bjnhur/WIZpm/01.Serial_to_ethernet_module/03.WIZ750SR-100/05.ETC/WIZ750SR-100_image/WIZ750SR-100_module_picture.png

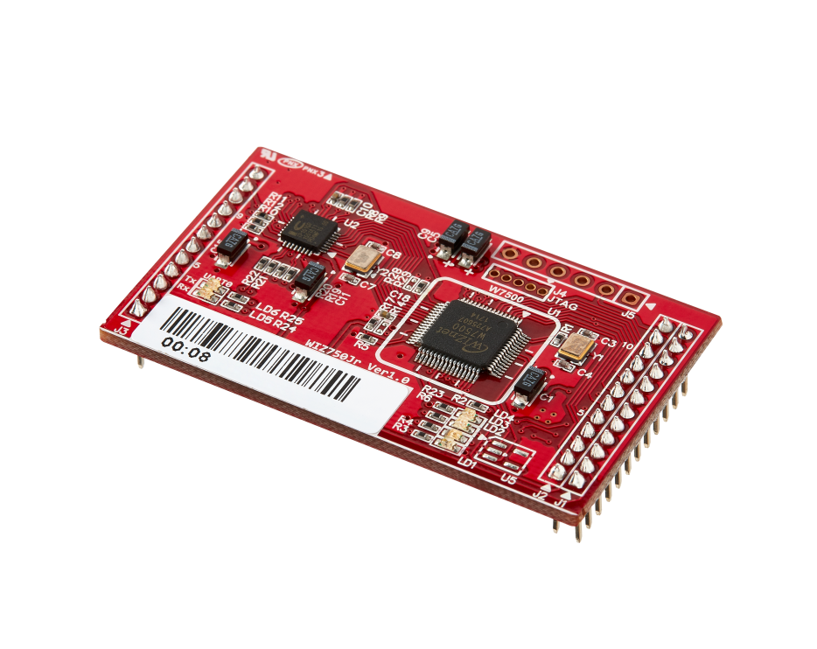
01.Serial_to_ethernet_module/03.WIZ750SR-100/05.ETC/WIZ750SR-100_image/WIZ750SR-100_module_picture.png
