bjnhur/WIZpm/README.md

# WIZpm
WIZnet product Management

File server와 WIZPM에서 설계 자료 수집 및 제품 버전업 히스토리 파악
원본 파일과 PDF 파일 공유
Github wiki 작성
파일명 통일 - 제품명_파일종류_버전.xxx
- 파일종류
- 회로도 - SCH
- 거버파일 - GB
- 파트리스트 - PL
- 데이터시트 - DS
- 유저가이드 - UG
- 생산가이드 - PG 

버전 관리

V1.00 ⇒ V100, V2.01 ⇒ V201
ex) WIZwiki-W7500_SCH_V100
