bjnhur/WIZpm/01.Serial_to_ethernet_module/03.WIZ750SR-100/05.ETC/WIZ750SR-100_Pinout.pptx

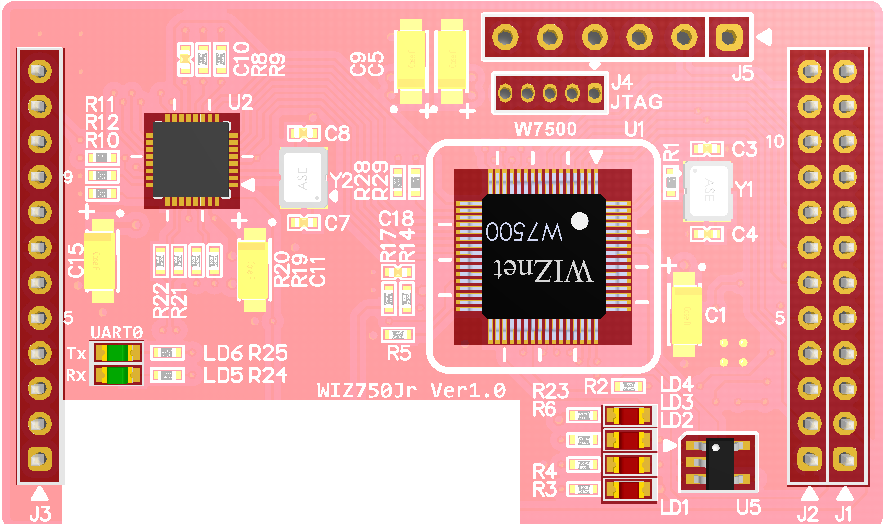
[picture p2: figure]

Expansion ISP port

JTAG

PHY

2

1x12
Network Trans Line

1x12
Data Trans Line

Main MCU
W7500

1

EEPROM

3

4

Indicate LED

Power LED

5

1x12
Expansion GPIO / App Boot / ISP Port

## Slide 2

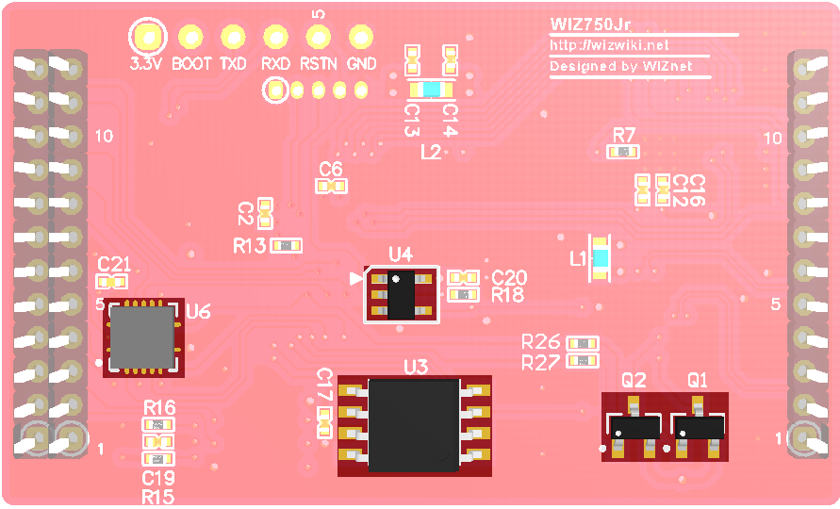
[picture p3: figure]

Qurdruple
3-state Buffer

6

7

Not Gate

PNP Transistor

9

Data Flash

8

## Slide 3

Expansion ISP port

JTAG

PHY

1x12
Network Trans Line

1x12
Data Trans Line

Main MCU
W7500

EEPROM

UART TX/RX LED

Indicate LED

Power LED

1x12
Expansion GPIO / App Boot / ISP Port

## Slide 4

Qurdruple
3-state Buffer

Not Gate

PNP Transistor

Data Flash

## Slide 5

JTAG

Network
Line
(10/100M) Ethernet

PA_04

VCC_3.3V

SWDIO

GND

/RESET

U_RXD2

PC_11

ISP

Data
Line

PA_03

SWCLK

/RESET

U_TXD2

BOOT

PC_10

GND

VCC_3.3V

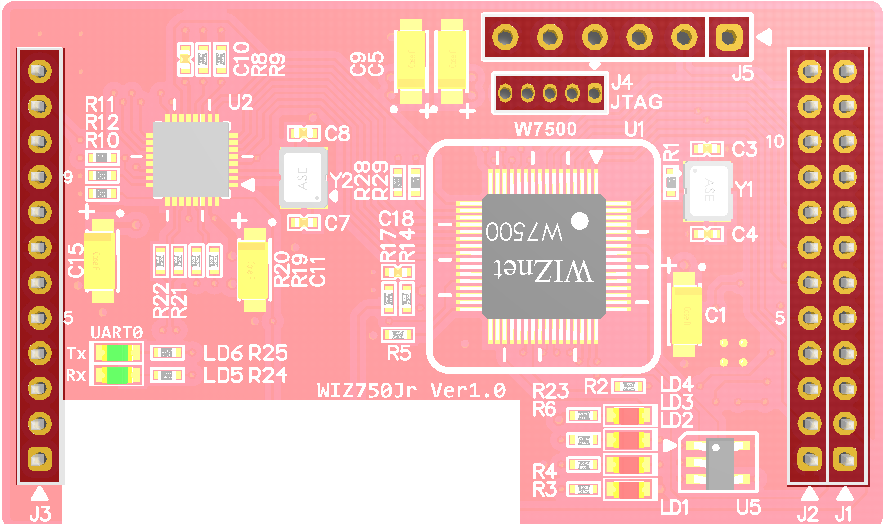
[picture p4: figure]

VCC_3.3V

STATUS

PA_07

PB_05

COL

PHY_AD3

GND

U_DSR

PA_09

NC

PHY_AD0

U_CTS

U_RXD

PA_11

PA_14

GND

MDI_TP

MDI_TN

GND

U_DTR

U_RTS

PA_10

PA_12

GND

MDI_RP

U_TXD

GND

PA_13

MDI_RN

NC

/RESET

VCC_3.3V

GND

APP_BOOT

EX_GPIOA

EX_GPIOB

EX_GPIOC

EX_GPIOD

U_RXD2

U_TXD2

BOOT

STAT_LED1

STAT_LED0

GND

PA_08

PC_15

PC_14

PC_13

PC_12

PC_11

PC_10

PC_09

PC_08

Optional Line
(Debug, Expansion GPIO, Status LED)

## Slide 6

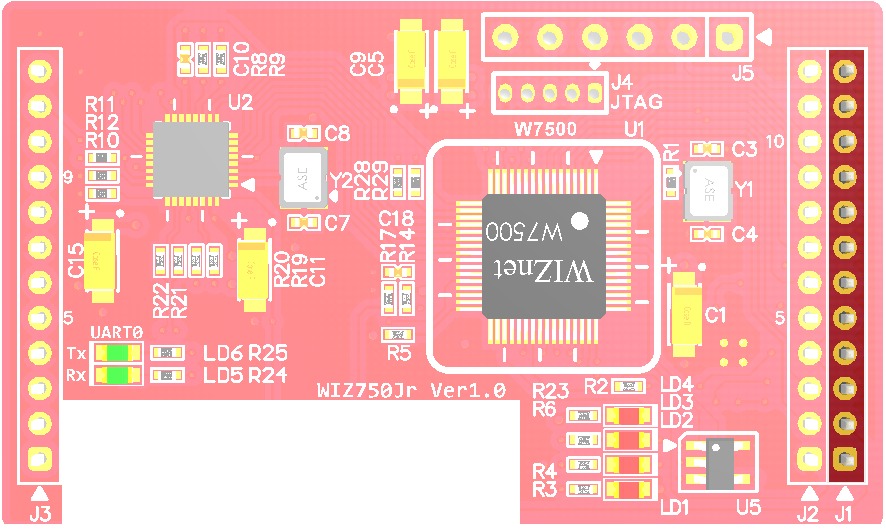
[picture p5: figure]

STATUS

GND

U_DSR

U_CTS

U_RXD

GND

U_DTR

U_RTS

U_TXD

GND

/RESET

VCC_3.3V

## Slide 7

VCC_3.3V

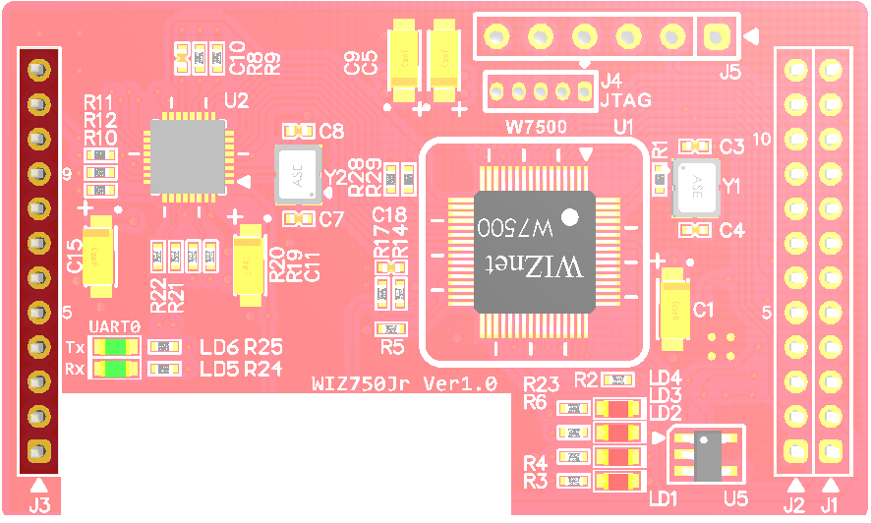
[picture p6: figure]

COL

PHY_AD3

NC

PHY_AD0

GND

MDI_TP

MDI_TN

GND

MDI_RP

MDI_RN

NC

## Slide 8

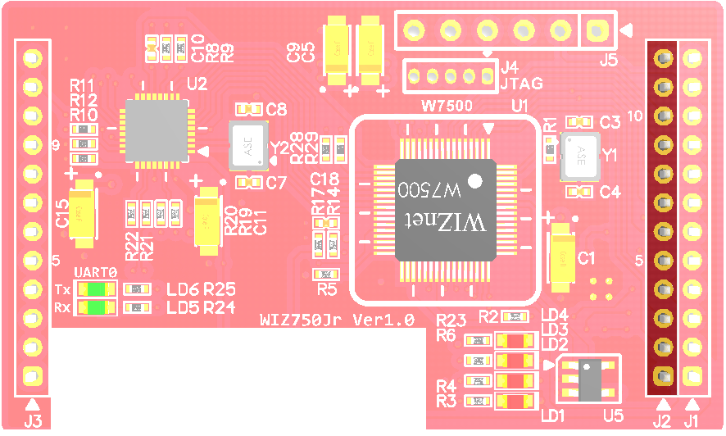
[picture p7: figure]

GND

APP_BOOT

EX_GPIOA

EX_GPIOB

EX_GPIOC

EX_GPIOD

U_RXD2

U_TXD2

BOOT

STAT_LED1

STAT_LED0

GND

## Slide 9

JTAG

GND

PA_03

/RESET

SWCLK

PA_04

SWDIO

VCC_3.3V

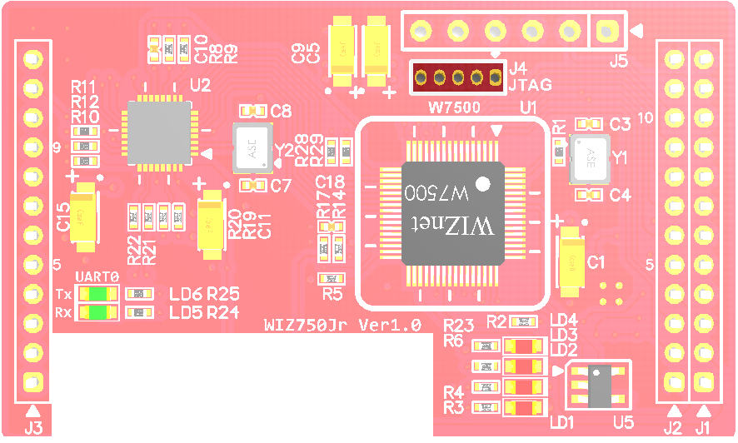
[picture p8: figure]

## Slide 10

GND

/RESET

U_RXD2

PC_11

ISP

U_TXD2

BOOT

PC_10

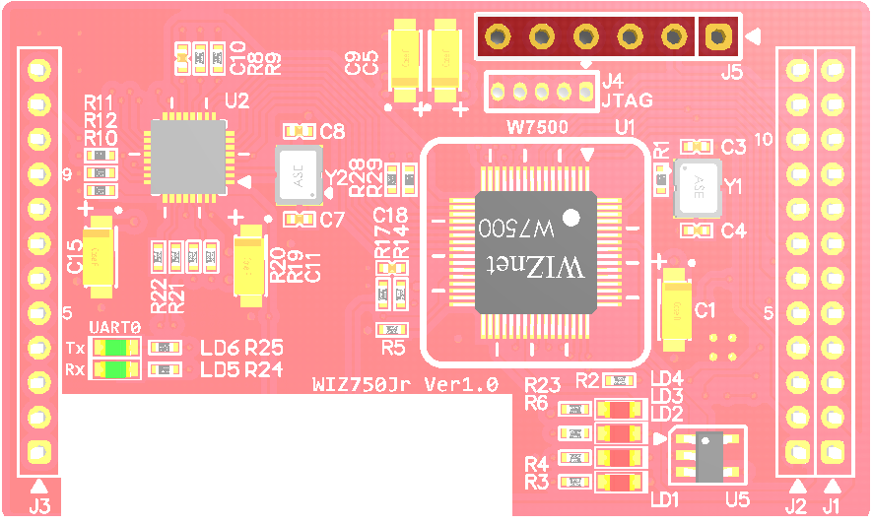
[picture p9: figure]

VCC_3.3V

## Slide 11

Indicate LED
(10/100_LED(ACT/LINK))
(COL LED) etc

Expansion GPIO

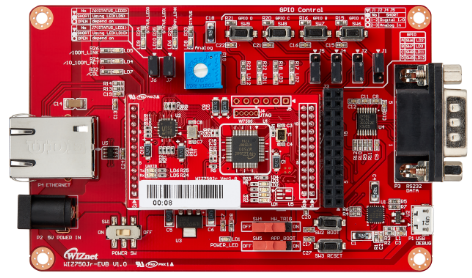
[picture p10: figure]

RS-232
Connector
(D-SUB9)

RJ-45
Connector

Power
Adapter

Micro USB B type
Debug/ISP Port

Boot Switch

Reset Switch

Power Switch

Mode Switch
Normal/Config

App Boot
Switch
