bjnhur/WIZpm/01.Serial_to_ethernet_module/06.WIZ750SR-110/05.ETC/WIZ750SR_110_Pinout.pptx

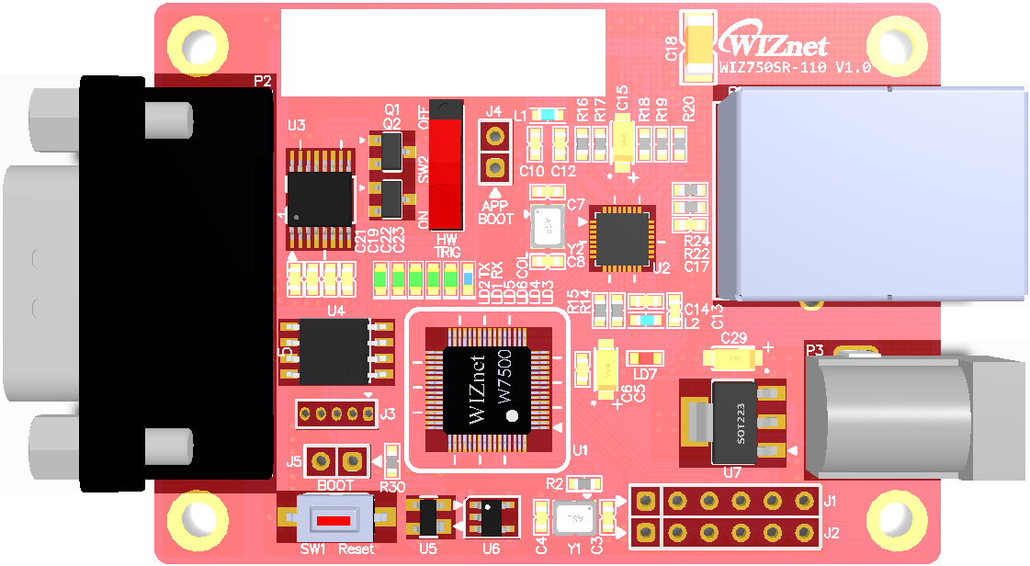
[picture p11: figure]

D-SUB9 Connector

8

RS-232C Transceiver

7

PNP Transistor

4

RJ-45
Ethernet Connector

3

App Boot

HW_TRIG
Slide SW

Main MCU
W7500

5

6

17

Data Flash

9

1

PHY

2

5v to 3.3v LDO

18

5V DC-JACK

10

11

16

JTAG

Boot

EEPROM

14

Expansion GPIO port

Expansion ISP port

15

Reset
Push SW

12

Reset IC

13

## Slide 2

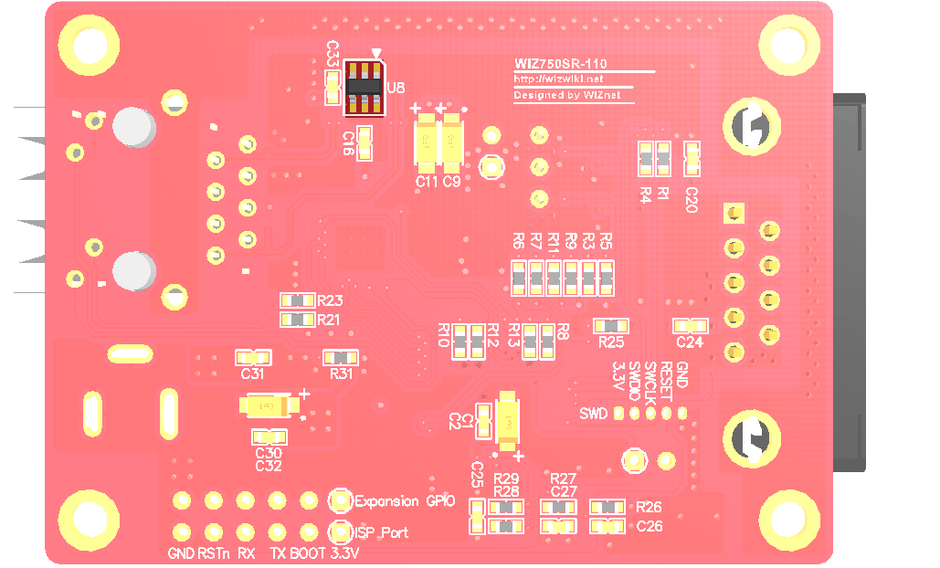
[picture p12: figure]

Ethernet line
ESD Protect

19

## Slide 3

D-SUB9 Connector

RS-232C Transceiver

PNP Transistor

RJ-45
Ethernet Connector

App Boot

HW_TRIG
Slide SW

Main MCU
W7500

Data Flash

PHY

5v to 3.3v LDO

5V DC-JACK

JTAG

Boot

EEPROM

Expansion GPIO port

Expansion ISP port

Reset
Push SW

Reset IC

## Slide 4

Ethernet line
ESD Protect

## Slide 5

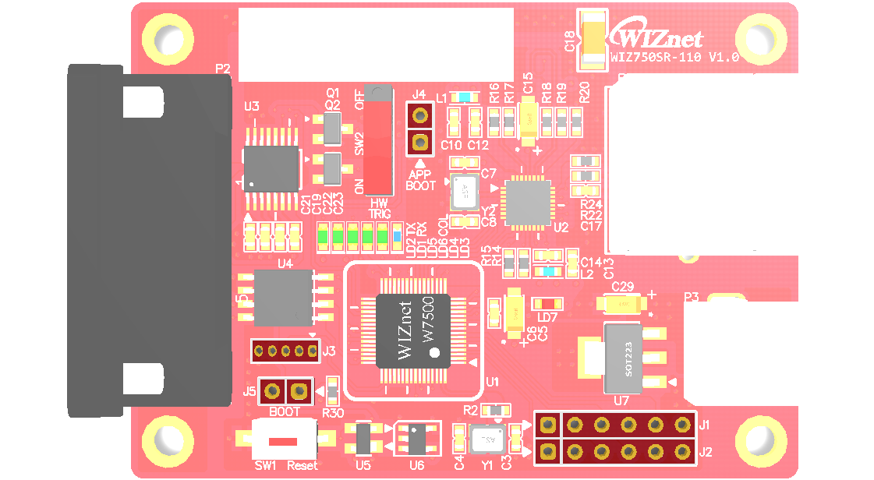
[picture p13: figure]

GND

APP BOOT

Boot

JTAG

PA_04

VCC_3.3V

SWDIO

PA_03

SWCLK

/RESET

VCC_3.3V

Expansion
GPIO

GND

GPIO_D

GPIO_C

GPIO_B

PC_12

PC_13

PC_14

GPIO_A

GND

PC_15

VCC_3.3V

BOOT

Boot

GND

ISP

/RESET

U_RXD2

PC_11

U_TXD2

BOOT

PC_10

VCC_3.3V

## Slide 6

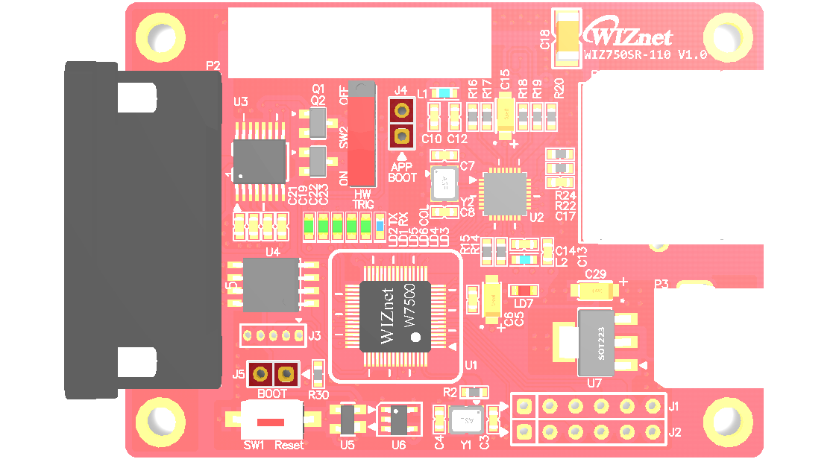
[picture p14: figure]

GND

APP BOOT

Boot

VCC_3.3V

BOOT

Boot

## Slide 7

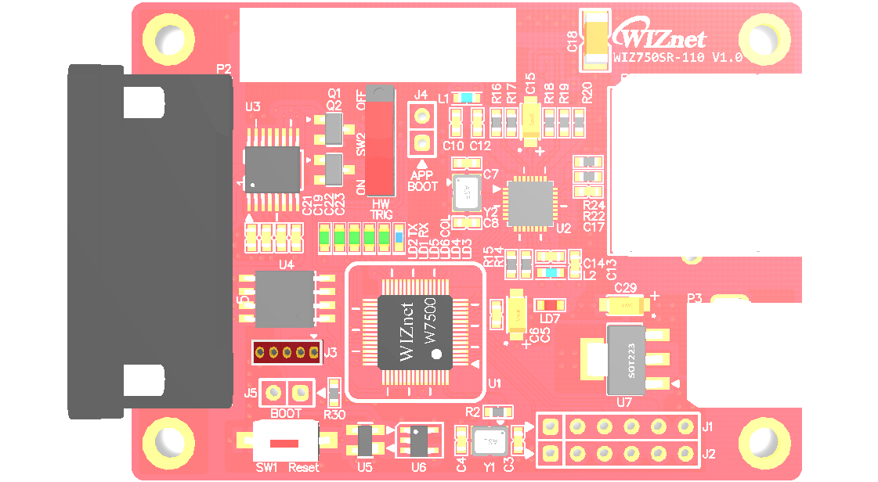
[picture p15: figure]

JTAG

PA_04

VCC_3.3V

SWDIO

PA_03

SWCLK

/RESET

GND

## Slide 8

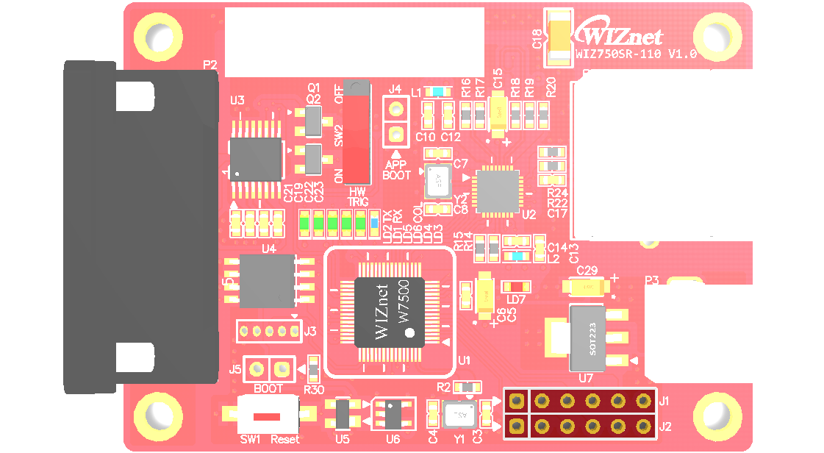
[picture p16: figure]

VCC_3.3V

Expansion
GPIO

ISP

GPIO_D

GPIO_C

GPIO_B

PC_12

PC_13

PC_14

GPIO_A

GND

PC_15

GND

/RESET

U_RXD2

PC_11

U_TXD2

BOOT

PC_10

VCC_3.3V

## Slide 9

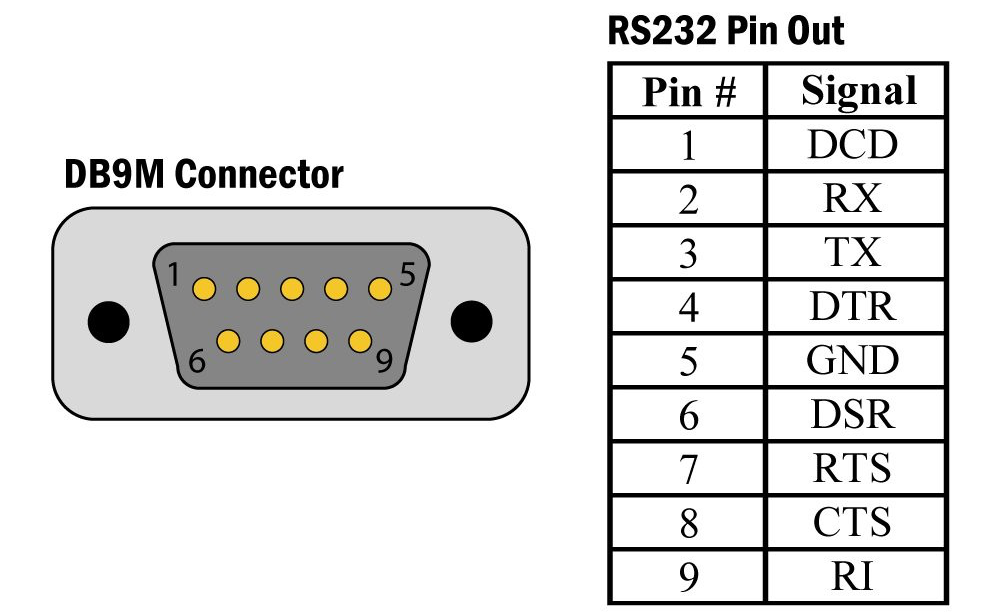
[picture p17: figure]
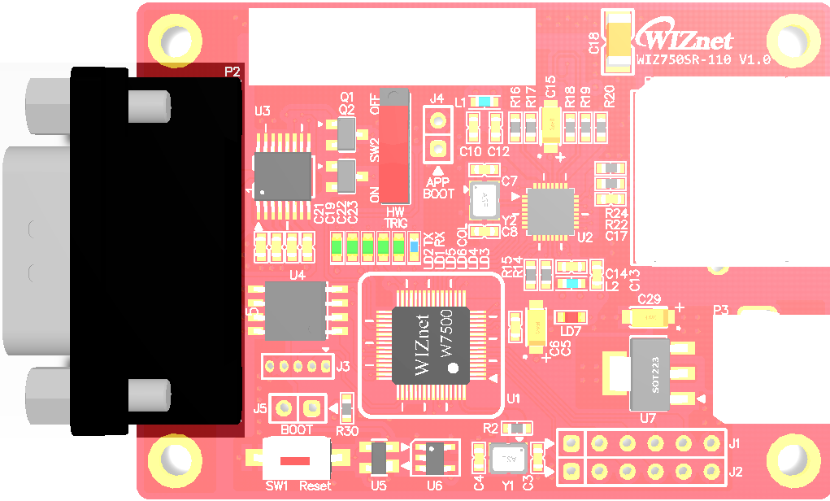
[picture p18: figure]

## Slide 10
