bjnhur/WIZpm/01.Serial_to_ethernet_module/02.WIZ750SR-EVB/05.ETC/WIZ750SR_EVB_BlockDiagram.pptx

<WIZ750SR-EVB (TTL/RS232)>

H/W Trig
Slide SW

BOOT
Slide SW

APP_BOOT
Slide SW

Reset SW
Tact SW

TVS Diode
SP0503BAHTG

Micro USB
Connector

ISP/Debug

DC JACK

Diode
BAT60A

USB to UART Bridge
CP2104

Debug UART

WIZ750SR

Digital In/out

Expansion GPIO Test

Diode
BAT60A

Power SW

3.3V LDO

Power LED

5V

RS232C
Serial Port
D-SUB9-MALE

DATA line

RS-232C
Transceiver

TTL / RS232 Operation
Jumper Select

Analog In

Potentialmeter

LED

LED

LED

LED

Tact SW

Tact SW

Tact SW

Tact SW

## Slide 2

<WIZ750SR-EVB (RS422/485)>

H/W Trig
Slide SW

BOOT
Slide SW

APP_BOOT
Slide SW

Reset SW
Tact SW

TVS Diode
SP0503BAHTG

Micro USB
Connector

ISP/Debug

DC JACK

Diode
BAT60A

USB to UART Bridge
CP2104

Debug UART

WIZ750SR

Digital In/out

Expansion GPIO Test

Diode
BAT60A

Power SW

3.3V LDO

Power LED

5V

RS422/485
Serial Port
ECH381R 6P

DATA line

Analog In

Potentialmeter

LED

LED

LED

LED

Tact SW

Tact SW

Tact SW

Tact SW
