bjnhur/WIZpm/01.Serial_to_ethernet_module/05.WIZ750SR-105/04.Documents/WIZ750SR-105_PG_V100.pdf

# WIZ750SR-105 Production Guide

## (Version 1.0)

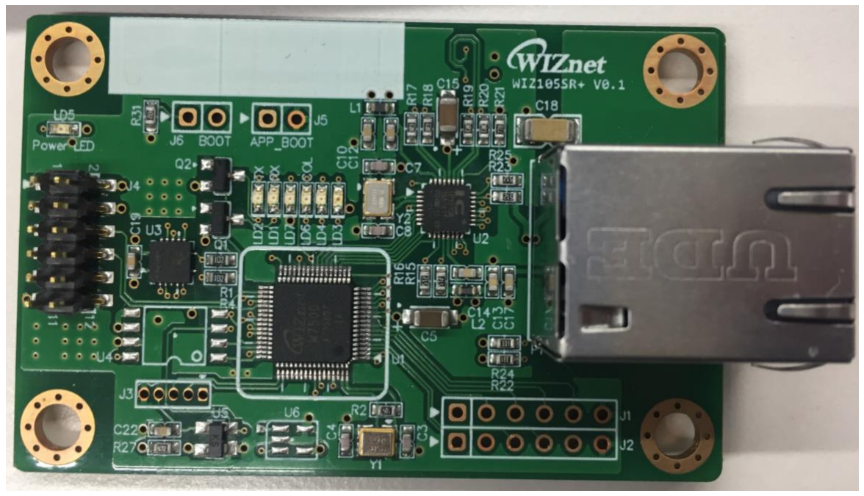
[picture p41: figure]

2018-01-15

ⓒ2016 WIZnet Co., Inc. All Rights Reserved.

☞For more information, visit our website at http://www.wiznet.io

WIZ750SR Production Guide (Version1.0) | 2

목차

## 1. 작업 환경 구성

### 1. 소프트웨어 환경

1. PC (Window 7 이상)
2. Python 2.7.13 program (파일로 제공)

파일이 없을 시 아래 설명 확인.

i. (https://www.python.org/downloads/release/python-2713/) 링크로 접속, Python

2.7.13 Windows x86-64 MSI installer 다운로드 (PC가 64bit일 경우)

ii. (32bit PC라면 Windows x86 MSI installer를 다운로드)

3. Mbed Serial Driver (파일로 제공)
| 파일이 없을 시 아래 설명 확인.
i. (https://os.mbed.com/handbook/Windows-serial-configuration) 링크로 접속.
| Download the mbed Windows serial port driver의 “Download latest driver” 클릭하 여 다운로드

### 2. WIZwiki 보드 mbed COM port 확인

1. WIZwiki-W7500P에 USB 케이블을 연결한 뒤, PC의 장치관리자에 들어가서 “mbed
| Serial Port”가 나오는지 확인한다.”


### 3. 프로그램 설치

1. Python 2.7.13 프로그램 설치

설치파일 실행 후 전부 “Next” 누르고 설치.

2. 환경변수 추가하기.

아래 사진과 같이 제어판 -> 시스템 -> 고급 시스템 설정 -> 환경변수로 접속한다.

그리고 시스템 변수의 Path에 C:\Python27;C:\Python27\Scripts 을 기입한 뒤 확인

을 누르고 나온다.


3. PyOCD 설치하기
i. 아래 사진과 같이 시작메뉴의 찾기 메뉴에서 명령 프롬프트(cmd)를 실행한다.

(주의: 반드시 인터넷이 연결되어 있어야 함.)

ii. | cmd환경에서 pip install --pre -U pyocd 명령어를 입력한 뒤 enter를 누른다.
| 그러면 아래 사진 처럼 pyOCD가 설치 된다.


iii. | 그리고 제공해 준 파일을 아래 사진과 같이 아래의 경로에 각각 복사한다.
| C\Python27\Lib\site-packages\pyOCD
| Flash_w7500.py >> Flash 폴더
| Mbed_board.py >> board 폴더
| Target_w7500.py >> target 폴더


## 2. 하드웨어 연결

### 1. 테스트 환경 준비 및 하드웨어 연결

- 테스트 환경
1. WIZwiki-W7500P & WIZwiki-W7500 board (둘 중에 하나 사용)
2. WIZ750SR-105
3. WIZ105SR-EVB Board

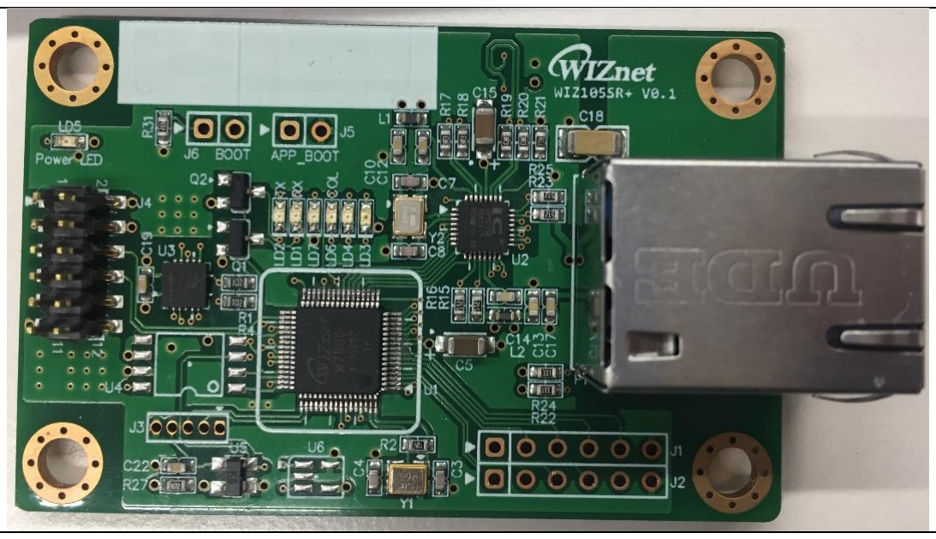
[picture p42: figure]

WIZ750SR-100 보드

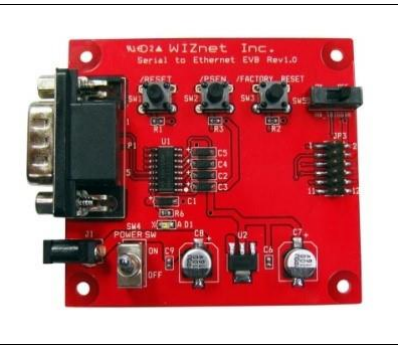
[picture p43: figure]

WIZ105SR-EVB

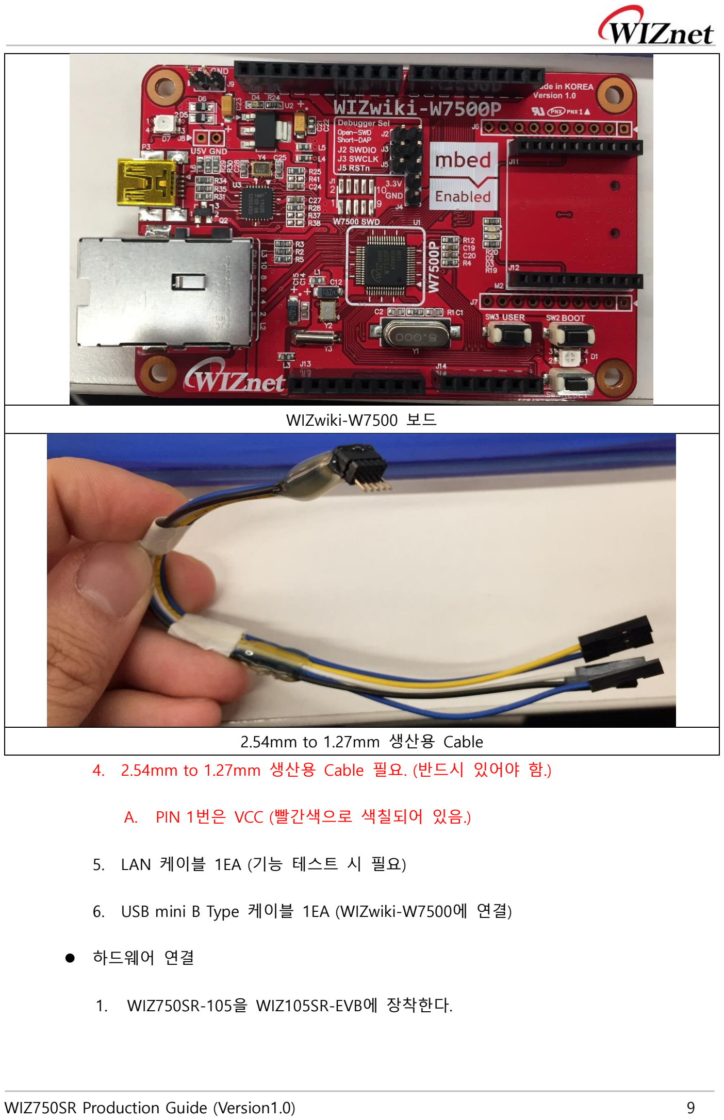
[picture p44: page 9]

WIZwiki-W7500 보드

2.54mm to 1.27mm 생산용 Cable

4. 2.54mm to 1.27mm 생산용 Cable 필요. (반드시 있어야 함.)
A. PIN 1번은 VCC (빨간색으로 색칠되어 있음.)
5. LAN 케이블 1EA (기능 테스트 시 필요)
6. USB mini B Type 케이블 1EA (WIZwiki-W7500에 연결)
- 하드웨어 연결
1. WIZ750SR-105을 WIZ105SR-EVB에 장착한다.

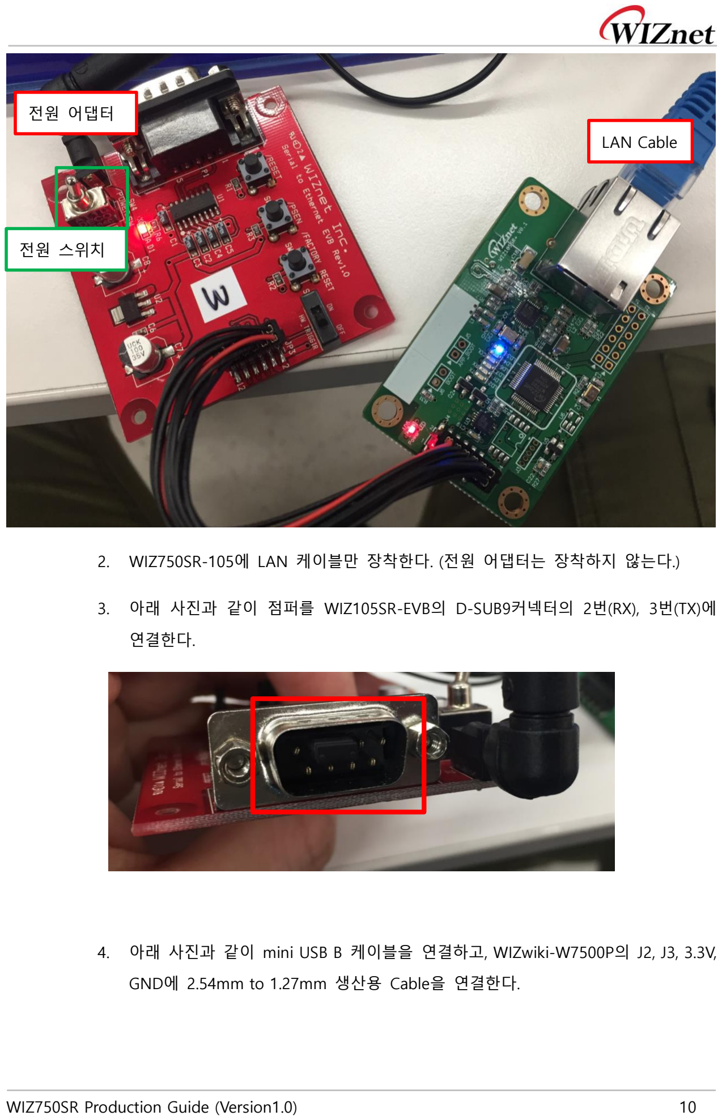
[picture p45: page 10]

2. WIZ750SR-105에 LAN 케이블만 장착한다. (전원 어댑터는 장착하지 않는다.)
3. 아래 사진과 같이 점퍼를 WIZ105SR-EVB의 D-SUB9커넥터의 2번(RX), 3번(TX)에

연결한다.

4. 아래 사진과 같이 mini USB B 케이블을 연결하고, WIZwiki-W7500P의 J2, J3, 3.3V,

GND에 2.54mm to 1.27mm 생산용 Cable을 연결한다.

LAN Cable

전원 어댑터

전원 스위치

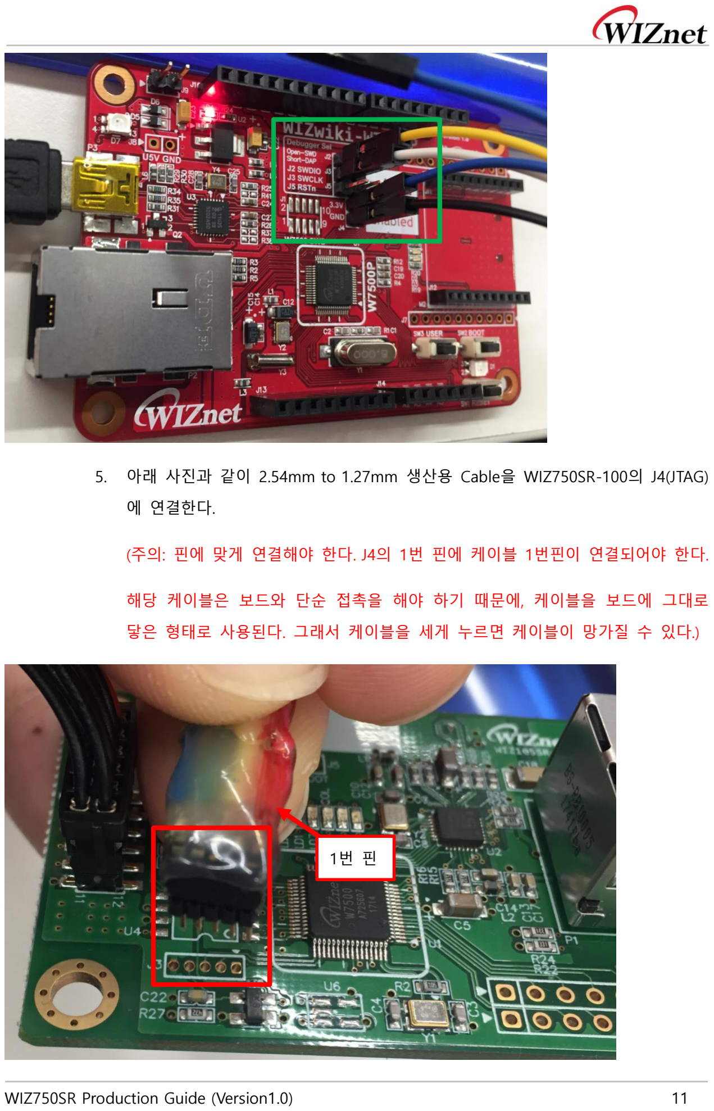
[picture p46: page 11]

5. 아래 사진과 같이 2.54mm to 1.27mm 생산용 Cable을 WIZ750SR-100의 J4(JTAG)

에 연결한다.

(주의: 핀에 맞게 연결해야 한다. J4의 1번 핀에 케이블 1번핀이 연결되어야 한다.

해당 케이블은 보드와 단순 접촉을 해야 하기 때문에, 케이블을 보드에 그대로

닿은 형태로 사용된다. 그래서 케이블을 세게 누르면 케이블이 망가질 수 있다.)

1번 핀

6. 정상적으로 연결 되었다면, 아래 사진과 같이 LD1 LED에 빨간 불이 점등된다.
7. 이 상태에서 펌웨어, 맥 어드레스 라이팅, 기능테스트를 진행한다.

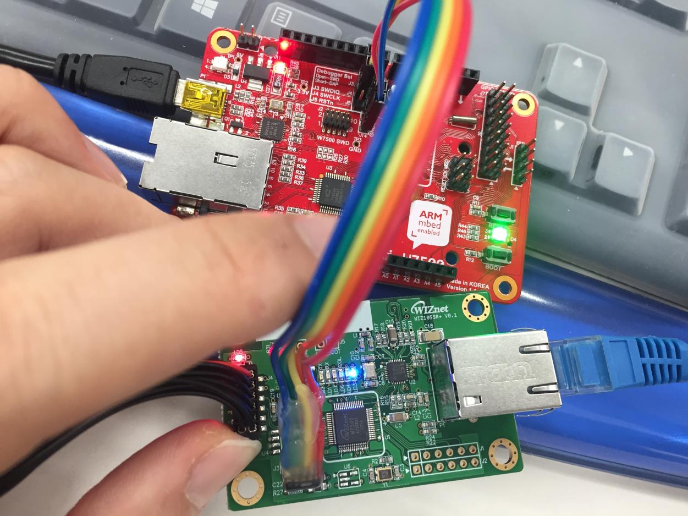
[picture p47: figure]

## 3. 펌웨어, 맥 어드레스 라이팅 및 기능 테스트

### 1. 펌웨어 라이팅

1. 펌웨어 다운로드 폴더로 접속한다. (제공한 파일 중 펌웨어 파일)

Ex) D:\Wiznet\WIZnet_product\_python_w7500_product\test_src_v2\test_src

2. 아래 사진과 같이 주소 표시줄에 cmd를 입력 후 Enter를 한다.


3. 그럼 아래 사진과 같이 cmd화면이 실행된다.
4. python w7500flashing.py -f W7500.bin 명령어를 입력하면 펌웨어 다운로드 시작한다.

해당 명령어가 나오면 펌웨어 다운로드

완료


### 2. 맥 어드레스 라이팅

1. 맥 어드레스 입력은 폴더의 macaddr.txt를 수정하여 MAC address를 수정할 수 있다.

아래 사진과 같이 맥 어드레스를 수정할 수 있다.

수정 후 저장한 뒤에 문서를 닫는다.

2. python w7500dataflashing.py 명령어를 입력하면 macaddr.txt에서 수정했던 맥 어드

레스가 라이팅 된다.

라이팅 된 후 자동 1씩 증가한다.

3. 여기까지 완료되었으면 라이팅 끝.

입력한 맥 어드레스

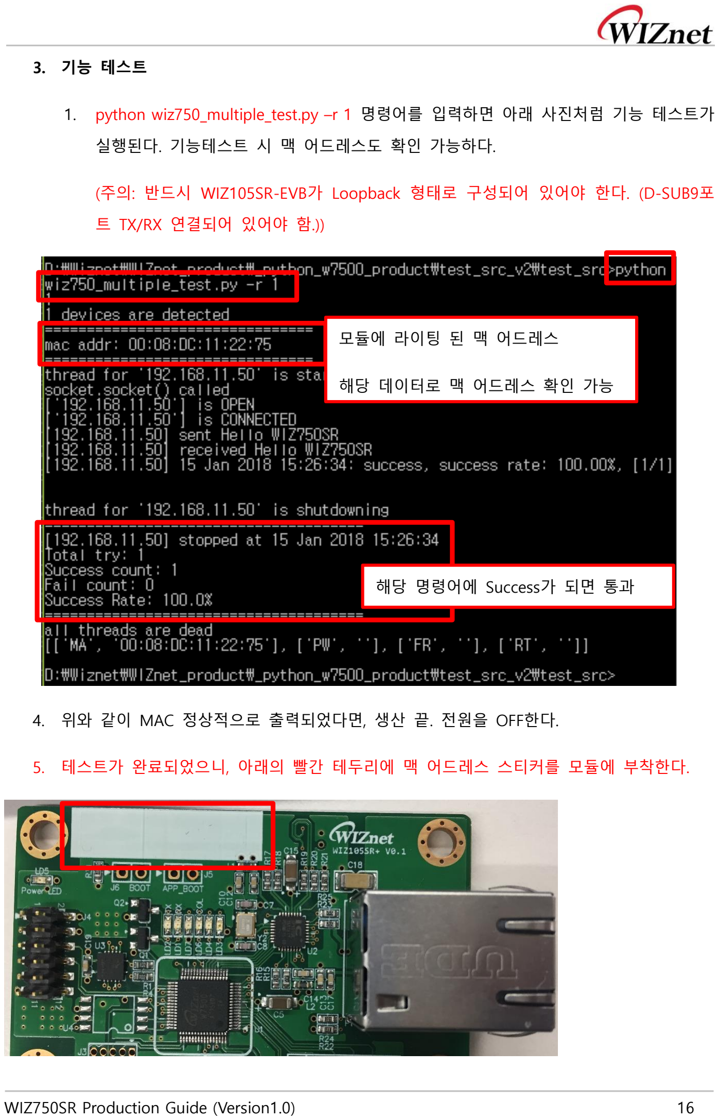
[picture p48: page 16]

### 3. 기능 테스트

1. python wiz750_multiple_test.py –r 1 명령어를 입력하면 아래 사진처럼 기능 테스트가

실행된다. 기능테스트 시 맥 어드레스도 확인 가능하다.

(주의: 반드시 WIZ105SR-EVB가 Loopback 형태로 구성되어 있어야 한다. (D-SUB9포

트 TX/RX 연결되어 있어야 함.))

4. 위와 같이 MAC 정상적으로 출력되었다면, 생산 끝. 전원을 OFF한다.
5. 테스트가 완료되었으니, 아래의 빨간 테두리에 맥 어드레스 스티커를 모듈에 부착한다.

해당 명령어에 Success가 되면 통과

모듈에 라이팅 된 맥 어드레스

해당 데이터로 맥 어드레스 확인 가능

## 4. 맥 어드레스 잘 못 입력했을 경우

1. 2. 하드웨어 연결에서 2. 2.54mm to 1.27mm 생산용 Cable을 WIZ750SR-105의 J4(JTAG)에

연결한다.

2. 펌웨어 다운로드 폴더로 접속한다. (제공한 파일 중 펌웨어 파일)

Ex) D:\Wiznet\WIZnet_product\_python_w7500_product\test_src_v2\test_src

3. 아래 사진과 같이 주소 표시줄에 cmd를 입력 후 Enter를 한다.


4. 그럼 아래 사진과 같이 cmd화면이 실행된다.
5. python w7500dataflashing.py -m 00:08:DC:xx:xx:xx 명령어를 입력하면 입력한 맥 어드레스

를 입력한다.

(주의: 해당 명령어는 macaddr.txt파일에 영향을 주지 않는다. 별도로 맥 어드레스를 입력

할 때 사용한다.)

별도로 입력된 맥 어드레스

## 5. 모듈에서 Error가 발생했을 때

1. 아래 사진과 같이 에러가 발생한다면, 다음과 같이 조치하면 된다.
A. Python W7500flashing.py(펌웨어 라이팅)할 때 발생하는 문제
i. 다시 한 번 라이팅 해본다.
ii. | 동일한 에러가 발생한다면, WIZwiki-W7500의 전원 OFF후 다시 ON한다.
iii. | 마찬가지로 W7500P-EVB보드도 전원 OFF후 다시 ON한다.


B. Python w7500dataflahing(맥 어드레스 라이팅)할 때 발생하는 문제.
i. WIZwiki-W7500의 전원 OFF후 다시 ON한다.

ii. 마찬가지로 W7500P-EVB보드도 전원 OFF후 다시 ON한다.

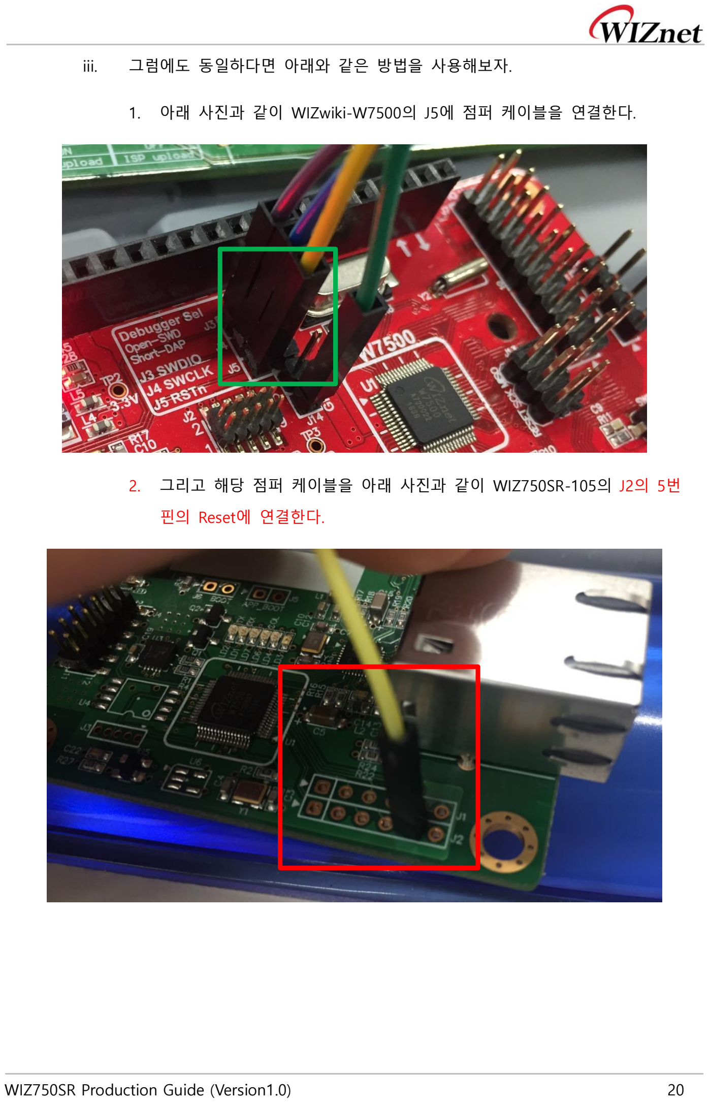
[picture p49: page 20]

iii. 그럼에도 동일하다면 아래와 같은 방법을 사용해보자.

1. 아래 사진과 같이 WIZwiki-W7500의 J5에 점퍼 케이블을 연결한다.
2. 그리고 해당 점퍼 케이블을 아래 사진과 같이 WIZ750SR-105의 J2의 5번

핀의 Reset에 연결한다.

3. 펌웨어 바이너리 파일을 WIZwiki-W7500의 이동식디스크에 드래그 앤 드랍

으로 복사한다.; 드래그 앤 드랍 복사

4. 그럼 아래 사진과 같이 다운로드가 시작된다.


5. 여기까지 완료되었다면, 다시 정상 동작한다.

## 6. WIZ750SR-105 생산 과정 요약

해당 생산 과정 요약본은 프로그램이 전부 설치되었다는 기준으로 설명한다.

1. WIZ750SR-105을 WIZ105SR-EVB에 장착한다.
2. WIZ105SR-EVB에 LAN 케이블만 장착한다. (전원 어댑터는 장착하지 않는다.)
3. 점퍼를 WIZ105SR-EVB의 D-SUB9커넥터의 2번(RX), 3번(TX)에 연결한다.
4. WIZwiki-W7500P보드에 mini USB B 케이블을 연결하고, J2, J3, 3.3V, GND에 2.54mm to

1.27mm 생산용 Cable을 연결한다.

5. 2.54mm to 1.27mm 생산용 Cable을 WIZ750SR-105의 J4(JTAG)에 연결한다.

(주의: 핀에 맞게 연결해야 한다. J4의 1번 핀에 케이블 1번핀이 연결되어야 한다.

해당 케이블은 보드와 단순 접촉을 해야 하기 때문에, 케이블을 보드에 그대로 닿은 형태

로 사용된다. 그래서 케이블을 세게 누르면 케이블이 망가질 수 있다.)

6. 펌웨어 다운로드 폴더로 접속한다. (제공한 파일 중 펌웨어 파일)
7. 아래 사진과 같이 주소 표시줄에 cmd를 입력 후 Enter를 한다.
8. python w7500flashing.py -f W7500.bin 명령어를 입력하면 펌웨어 다운로드 시작한다.
9. 맥 어드레스 입력은 폴더의 macaddr.txt를 수정하여 MAC address를 수정할 수 있다.
10. python w7500dataflashing.py 명령어를 입력하면 macaddr.txt에서 수정했던 맥 어드레스가

라이팅 된다.

11. python wiz750_multiple_test.py –r 1 명령어를 입력하면 기능 테스트가 실행된다. 기능테스

트 시 맥 어드레스도 확인가능하다.

(주의: 반드시 WIZ105SR-EVB가 Loopback 형태로 구성되어 있어야 한다. (D-SUB9포트

TX/RX 연결되어 있어야 함.))

12. 테스트가 완료되었으니, 맥 어드레스 스티커를 모듈에 부착한다.
