bjnhur/WIZpm/01.Serial_to_ethernet_module/02.WIZ750SR-EVB/01.Hardware/03.Partlist&BOM/01.WIZ750SR-EVB_TTL_PL/WIZ750SR-EVB_TTL_PL_V100.xls

WIZ750SR-EVB V1.0 TTL Version Partlist
Item | Q.ty | Reference | Part | Tech. Characteristics | Package
1 | 20 | C1,C2,C3,C4,C5,C6,C7,C8,C9,C10,C12,C14,C18,C19,C20,C21,C22,C23,C24,C25 | 0.1uF | 50V-5% Ceramic | CASE 0603
2 | 2 | C11,C15 | 4.7uF/16V | Tantal CAP, A Size, 4.7uF/16V, +/-20% | EIA/IECQ 3216
3 | 1 | C13 | 1uF | 50V-5% Ceramic | CASE 0603
4 | 2 | C16,C17 | 10uF/16V | Tantal CAP, A Size, 10uF/16V, +/-20% | EIA/IECQ 3216
5 | 2 | D1,D2 | BAT60A | Silicon Schottky Diode, 10V, 3A | SOD323
6 | 1 | D3 | Red LED | CHIP-LED, Red | CASE 0603
7 | 4 | D4,D5,D6,D7 | Green LED | CHIP-LED, Green | CASE 0603
8 | 4 | J1,J2,J3,J4 | 2.54mm 1x4 Pin haeder DIP | 2.54mm 1x4 Pin haeder DIP, Male | DIP
9 | 2 | J5,J6 | 2.54mm 1x2 Pin haeder DIP | 2.54mm 1x2 Pin haeder DIP, Male | DIP
10 | 4 | J8,J9,J10,J11 | 2.54mm 1x3 Pin haeder DIP | 2.54mm 1x3 Pin haeder DIP, Male | DIP
11 | 1 | J13 | 2.54mm 6x2 Pin Header Socket DIP | 2.54mm 6x2 Pin Header Socket DIP, Female | DIP
12 | 2 | J14,J15 | 2.54mm 1x6 Pin Header Socket DIP | 2.54mm 1x6 Pin Header Socket DIP, Female | DIP
13 | 1 | L1 | HH-1M1608-121JT | Bead for Power Line, 120[ohm] | CASE 0603
14 | 1 | P1 | D-SUB9-MALE | D-SUB 9PIN, Right-Angle, Male | R/A-Male
15 | 1 | P2 | 47346-0001 | Micro Mini B Type, SMD | SMD
16 | 1 | P3 | DC-JACK 2pi | DC Power Jack 2pi | DIP
17 | 5 | R1,R7,R8,R11,R12 | 4.7K | 1/10W-5% SMD | CASE 0603
18 | 2 | R2,R3 | 22R | 1/10W-5% SMD | CASE 0603
19 | 5 | R6,R9,R10,R13,R14 | 330R | 1/10W-5% SMD | CASE 0603
20 | 1 | R15 | WIW3386P / 10K | WIW3386P / 10K, Trimmer | DIP
21 | 1 | SW1 | SK-12D02 | 3 Port SW , SPDT ON-ON , 50V, 0.3A | DIP
22 | 5 | SW2,SW6,SW7,SW8,SW9 | IT-1101NHA-180G(SMD) | TACT Switch(SMD) | SMD
23 | 3 | SW3,SW4,SW5 | ITS-12H | Slide Switch(DIP) | DIP
24 | 2 | U1, U2 | SP3232EBEY | True +3.0V to +5.5V RS-232 Transceivers | TSSOP16
25 | 1 | U3 | CP2104-GM | SINGLE-CHIP USB-TO-UART BRIDGE, QFN-24 | QFN
26 | 1 | U4 | SP0503BAHTG | Little Fuse, Silicon Protection TVS Array Diode | SOT-143
27 | 1 | U5 | IL1117C-33ET | 3.3V 1A Low dropout Voltage Regulator | SOT-223
28 | 15 |  | 881545-1 | Jumper CAP | Item NO.8 &9 & 10에 장착 Item NO.8은 1-2 & 3-4 장착 Item NO.10중 J11은 2-3에 장착 나머지는 1-2번에 장착
29 | 1 | J7 | 2.54mm 1x2 Pin haeder DIP | Not Mount | DIP
30 | 1 | J12 | 2.54mm 1x6 Pin Header Socket DIP | Not Mount | DIP
31 | 1 | J16 | 2.54mm 1x2 Pin Header Socket DIP | Not Mount | DIP
32 | 1 |  | PCB | 2-Layer 83mm x 65mm
