bjnhur/WIZpm/01.Serial_to_ethernet_module/03.WIZ750SR-100/01.Hardware/01.Schematic/WIZ750SR-100_SCH_V100.pdf

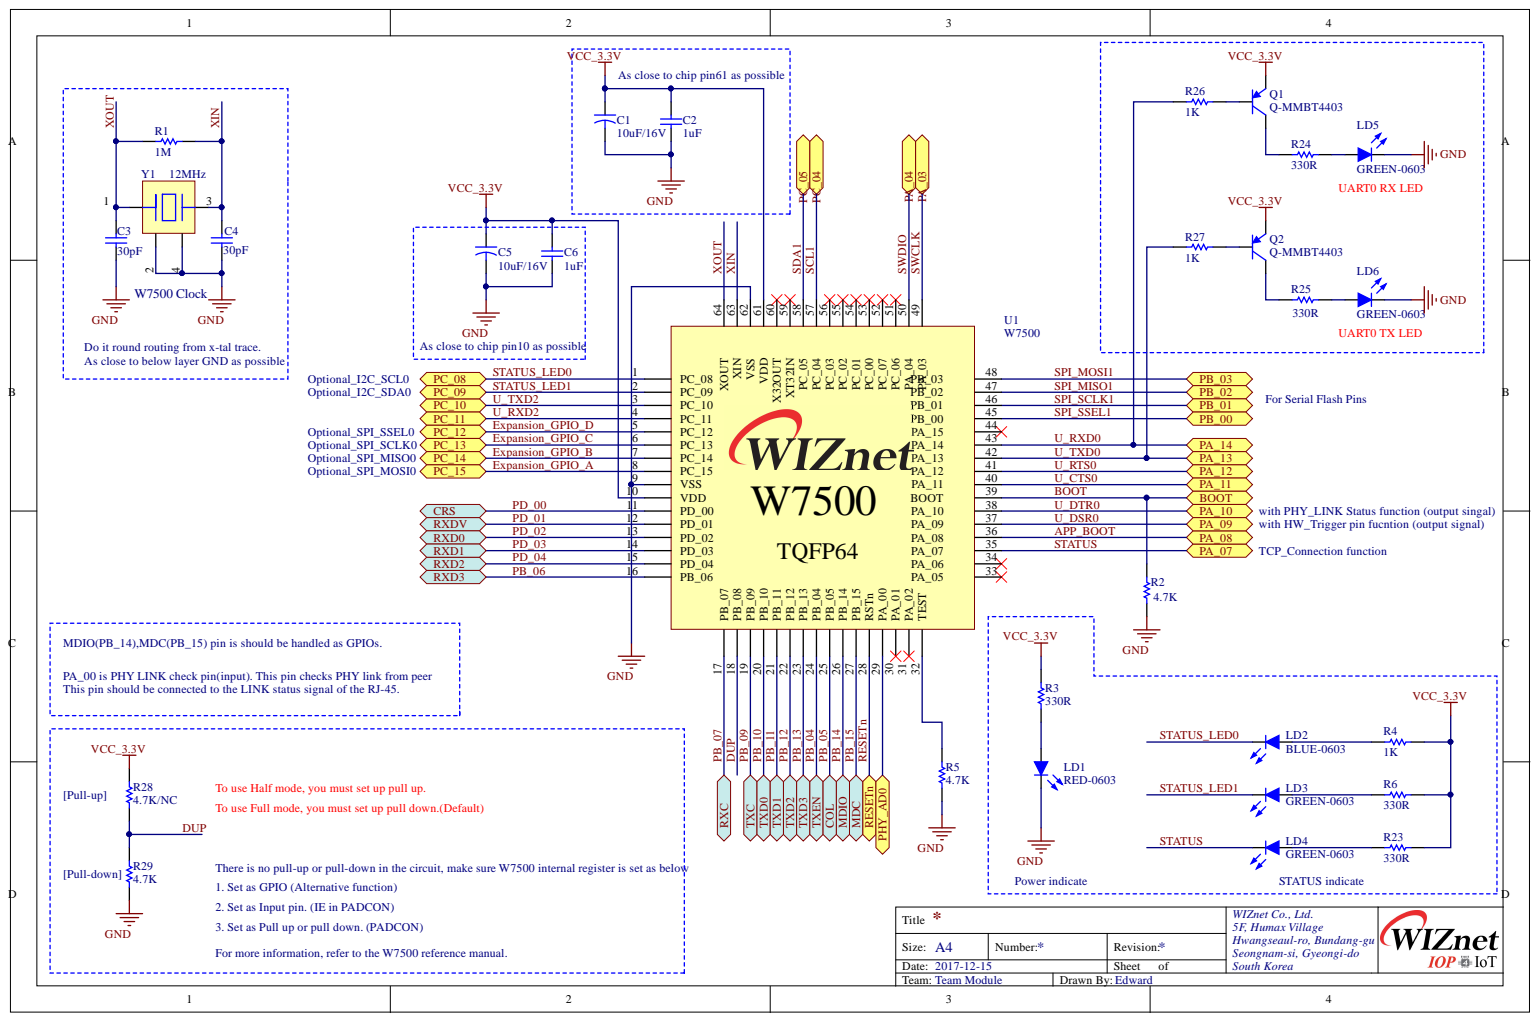
[picture p71: page 1]

VCC_ 3.3 | V

PC_ 0 8 PC_ 0 9 PC_ 1 0 PC_ 1 1 PC_ 1 2 PC_ 1 3 PC_ 1 4 PC_ 1 5 | W75 0 0 PA _ 1 0 PA _ 0 9 PA _ 0 8 TQFP64 PA _ 0 7 PA _ 0 6 0 5

GPIO _ D PC_12 | 5

GPIO _ C | 6
GPIO _ B | 7

A PC_14 GPIO _ | 8

0 | V D D PD _ 0 0 PD _ 0 1 PD _ 0 2 PD _ 0 3 PD _ 0 4 PB_ 0 6

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

A4 Team Mo Size: | * N umber: | * Rev i s i o n :

7-1 2-1 | | Sheet o f
d u l e | Draw n By : E d ward

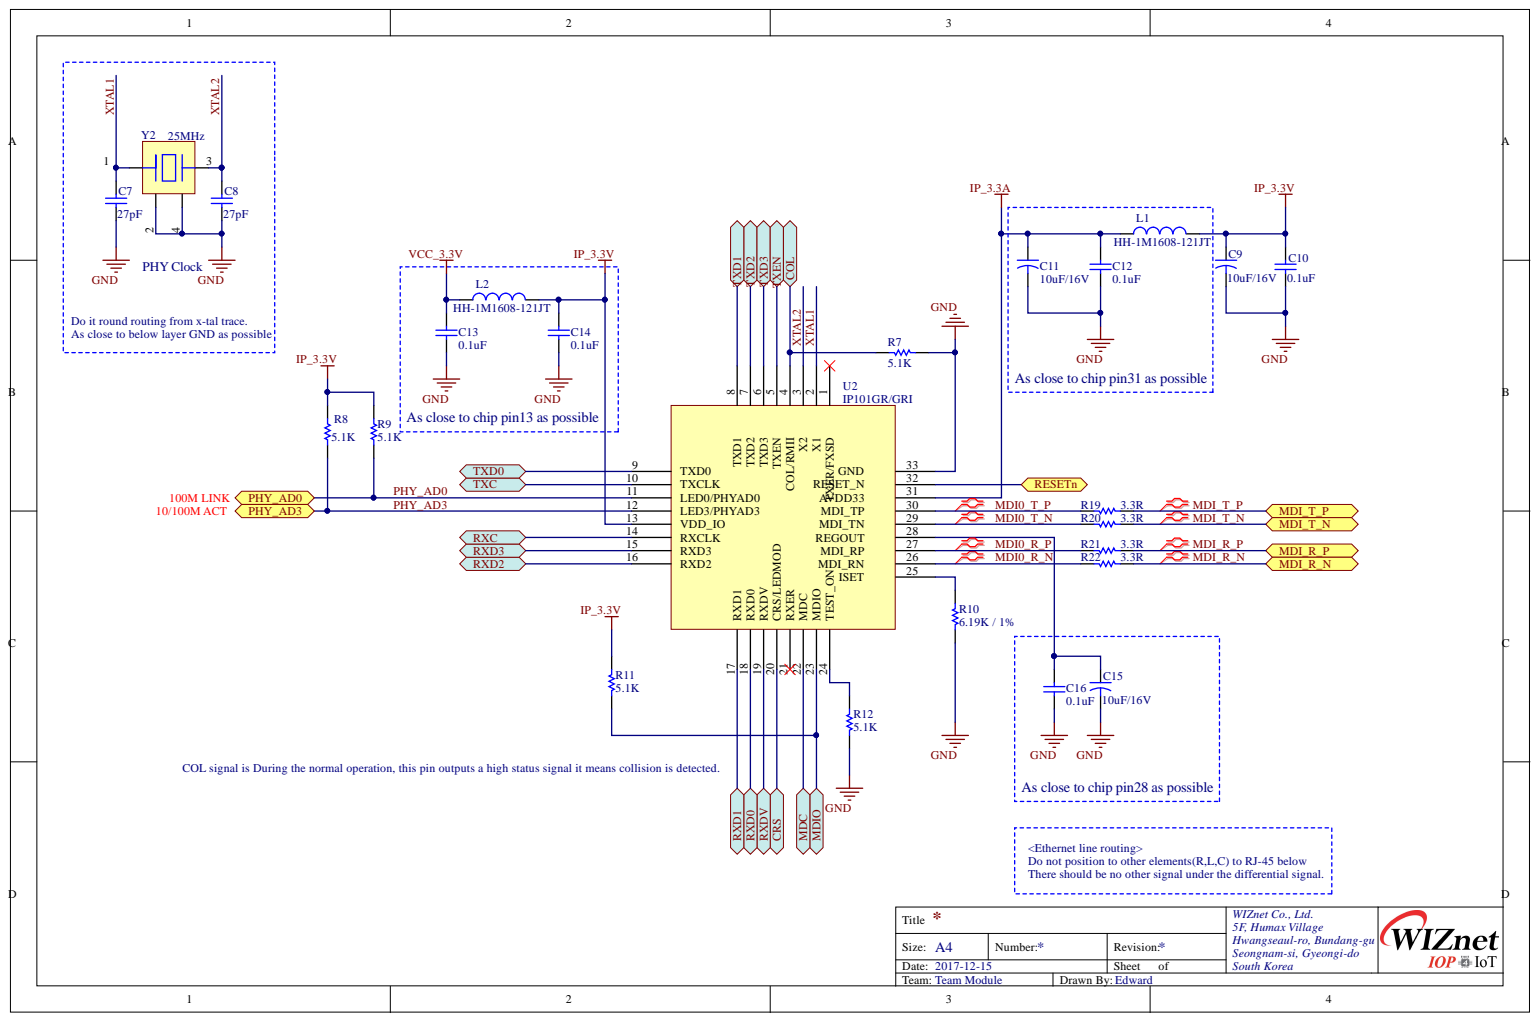
[picture p72: page 2]

Do it round routing from x-tal trace.
As close to below layer GND as possible

As close to chip pin31 as possible

TXER/FXSD 1 X1 2 X2 3 COL/RMII 4 TXEN 5 TXD3 6 TXD2 7 TXD1 8

MDI0_R_P MDI0_R_N R10 6.19K / 1%

COL signal is During the normal operation, this pin outputs a high status signal it means collision is detected.

As close to chip pin28 as possible

<Ethernet line routing>
Do not position to other elements(R,L,C) to RJ-45 below
There should be no other signal under the differential signal.

* Title | WIZnet Co., Ltd. 5F, Humax Village Hwangseaul-ro, Bundang-gu Seongnam-si, Gyeongi-do South Korea

A4 Size: | * Number: | * Revision:
Date: 2017-12-15 | | Sheet of
Team: Team Module | Drawn By: Edward

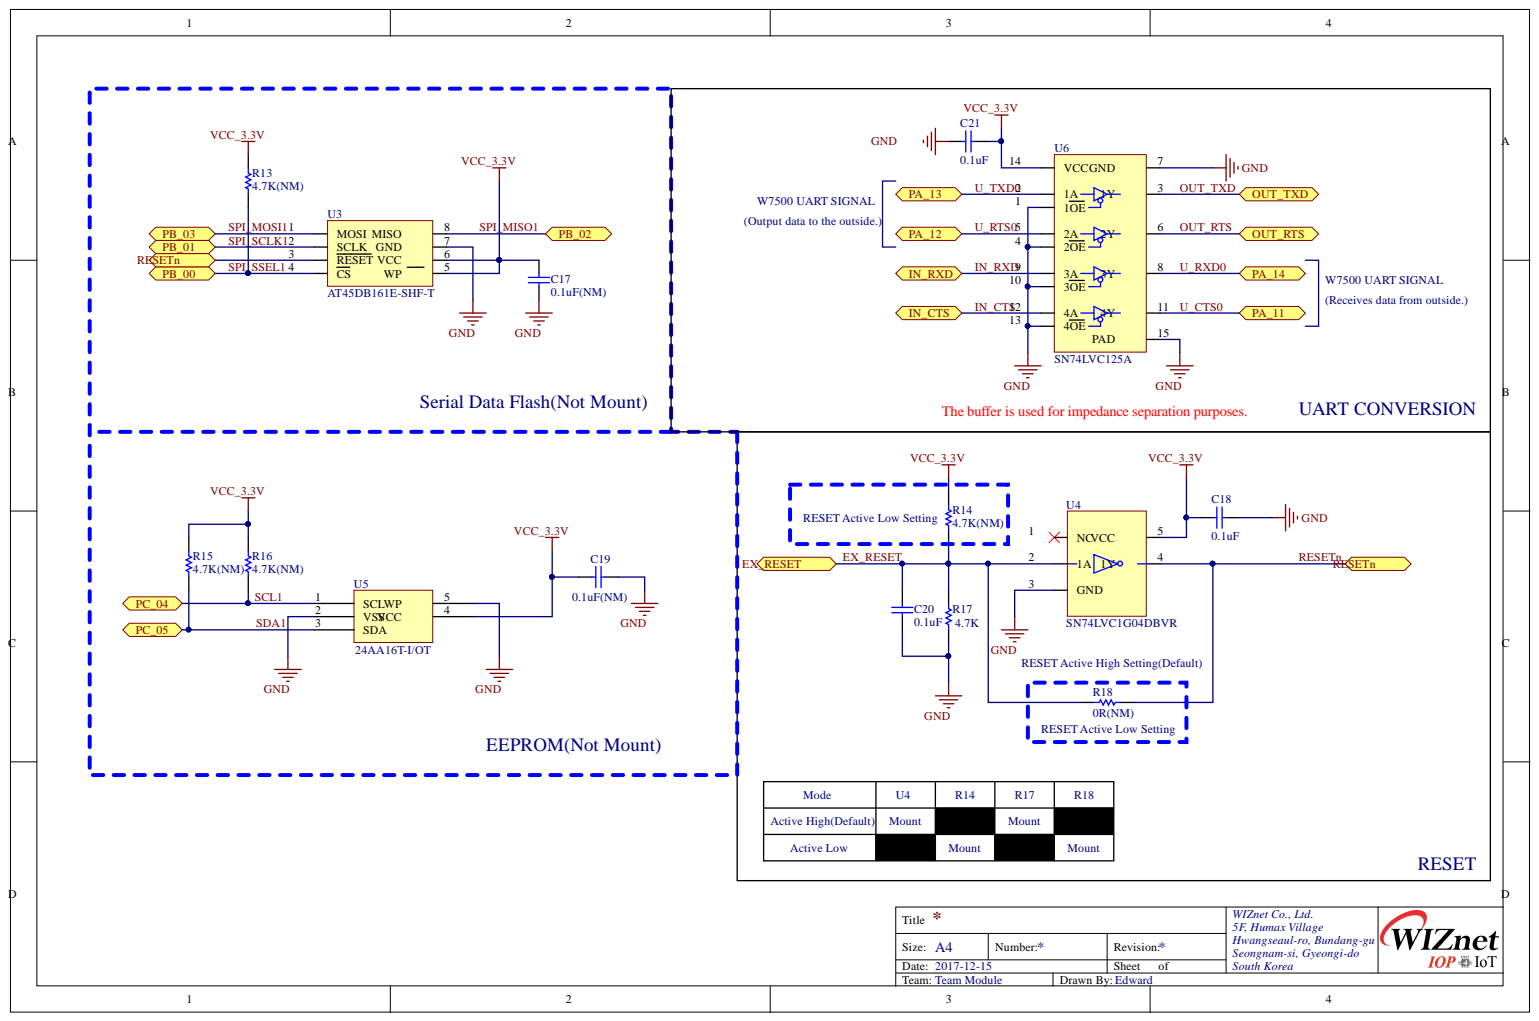
[picture p73: page 3]

W7500 UART SIGNAL
(Output data to the outside.)

(Receives data from outside.)

Serial Data Flash(Not Mount)

4.7K(NM) RESET Active Low Setting

GND
RESET Active High Setting(Default)

RESET Active Low Setting

Mode | U4 | R14 | R17 | R18

Active High(Default) | Mount | | Mount

Active Low | | Mount | | Mount

* Title | WIZnet Co., Ltd. 5F, Humax Village Hwangseaul-ro, Bundang-gu Seongnam-si, Gyeongi-do

A4 Size: | * Number: | * Revision:

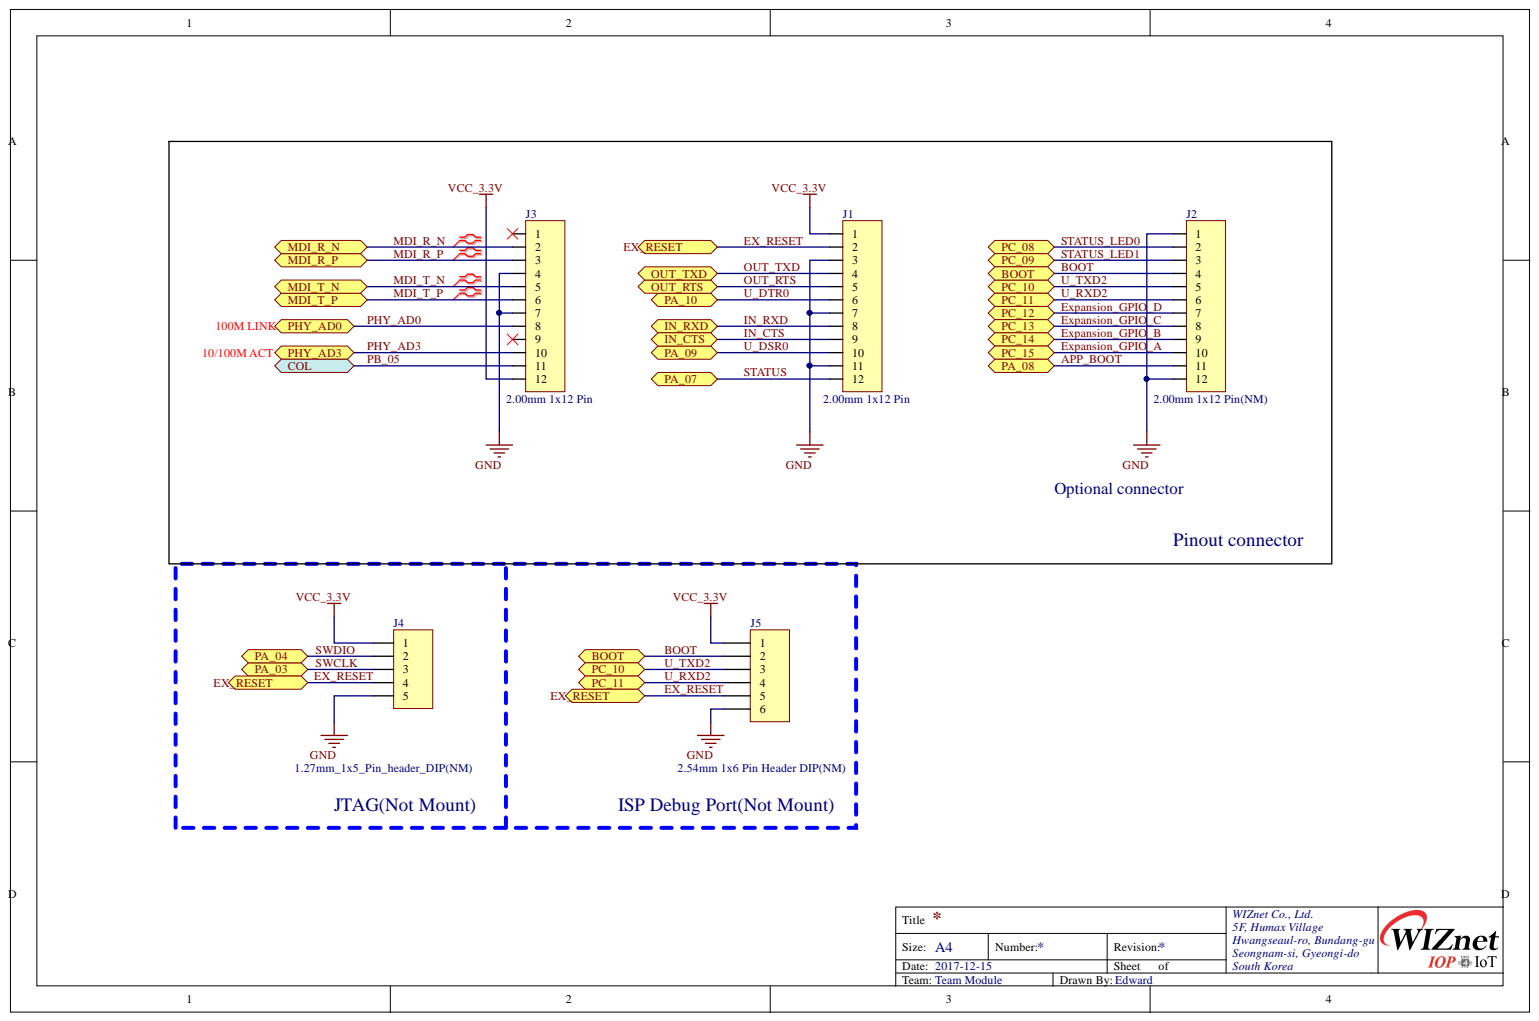
[picture p74: page 4]

GND
2.54mm 1x6 Pin Header DIP(NM)

ISP Debug Port(Not Mount)

* Title | WIZnet Co., Ltd. 5F, Humax Village Hwangseaul-ro, Bundang-gu Seongnam-si, Gyeongi-do

A4 Size: | * Number: | * Revision:
