bjnhur/WIZpm/01.Serial_to_ethernet_module/05.WIZ750SR-105/01.Hardware/01.Schematic/WIZ750SR-105_SCH_V100.pdf

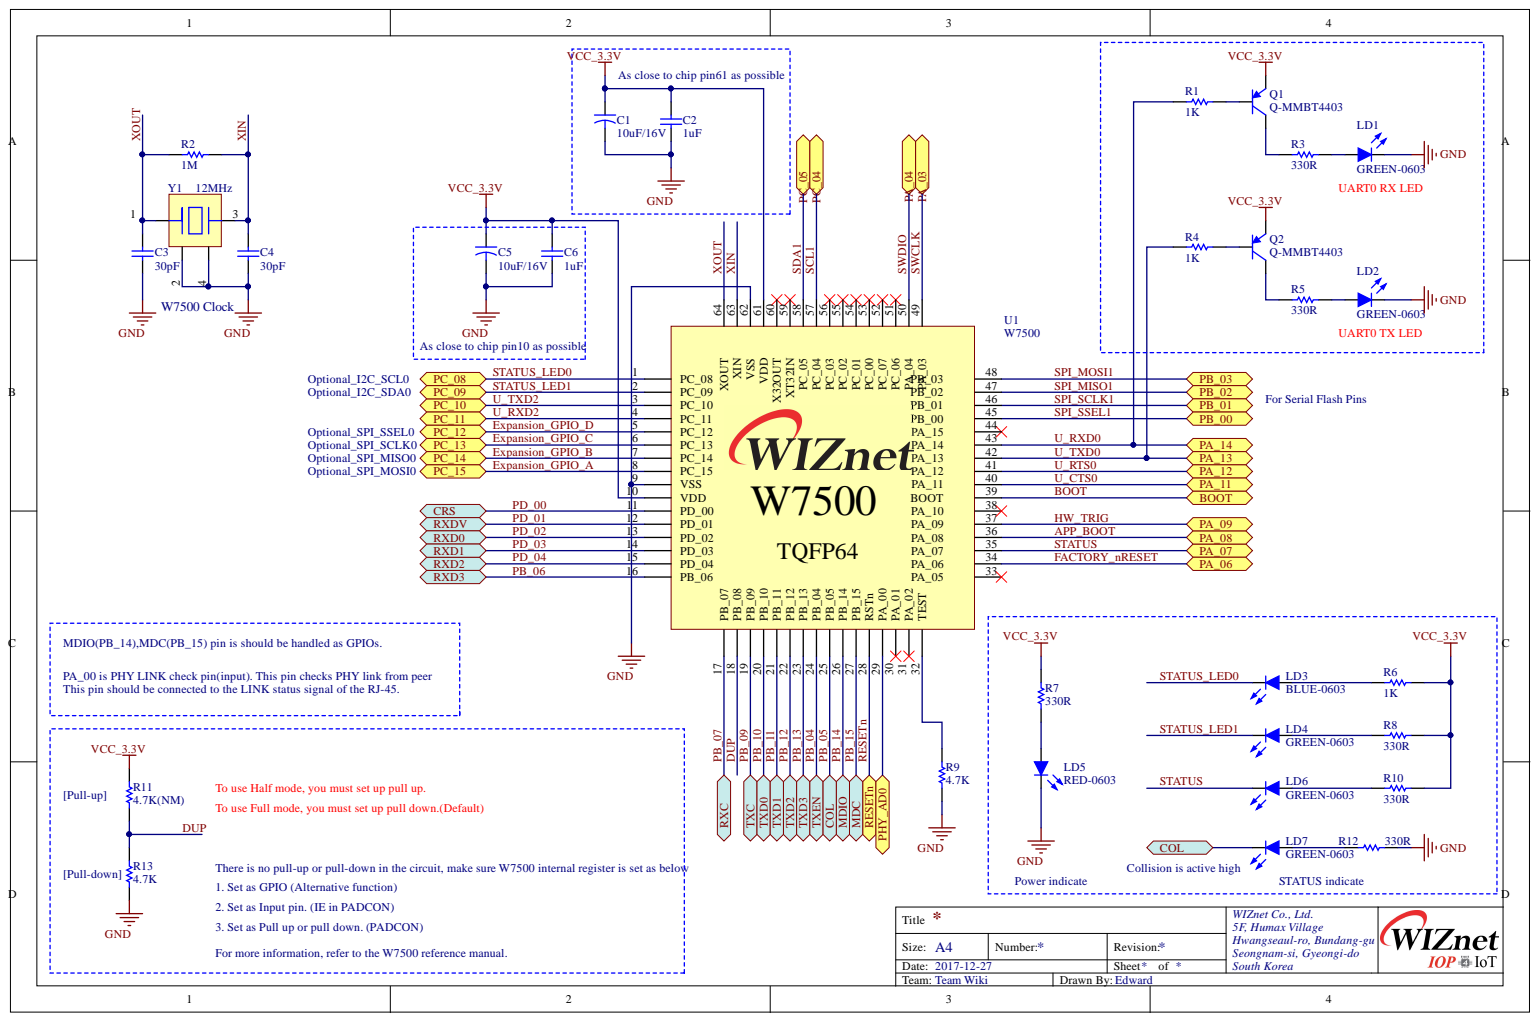
[picture p75: page 1]

VCC_3.3V

As close to chip pin61 as possible

GND | C6 1uF

PA_03 49 PA_04 50 PC_06 51 PC_07 52 PC_00 53 PC_01 54 PC_02 55 PC_03 56 PC_04 57 PC_05 58 XT32IN 59 X32OUT 60 VDD 61 VSS 62 XIN 63 XOUT 64

As close to chip pin10 as possible

PC_09 2
PC_10 3
PC_11 4
PC_12 5
PC_13 6
PC_14 7
PC_15 8
VSS 9
VDD 10
PD_00 11
PD_01 12
PD_02 13
PD_03 14
PD_04 15

For Serial Flash Pins

MDIO(PB_14),MDC(PB_15) pin is should be handled as GPIOs.

PA_00 is PHY LINK check pin(input). This pin checks PHY link from peer
This pin should be connected to the LINK status signal of the RJ-45.

To use Half mode, you must set up pull up.
To use Full mode, you must set up pull down.(Default)
DUP

COL
Collision is active high

There is no pull-up or pull-down in the circuit, make sure W7500 internal register is set as below
1. Set as GPIO (Alternative function)
2. Set as Input pin. (IE in PADCON)
3. Set as Pull up or pull down. (PADCON)

* Title | WIZnet Co., Ltd. 5F, Humax Village Hwangseaul-ro, Bundang-gu Seongnam-si, Gyeongi-do South Korea

For more information, refer to the W7500 reference manual.

A4 Size: | * Number: | * Revision:
Date: 2017-12-27 | | Sheet * of *
Team: Team Wiki | Drawn By: Edward

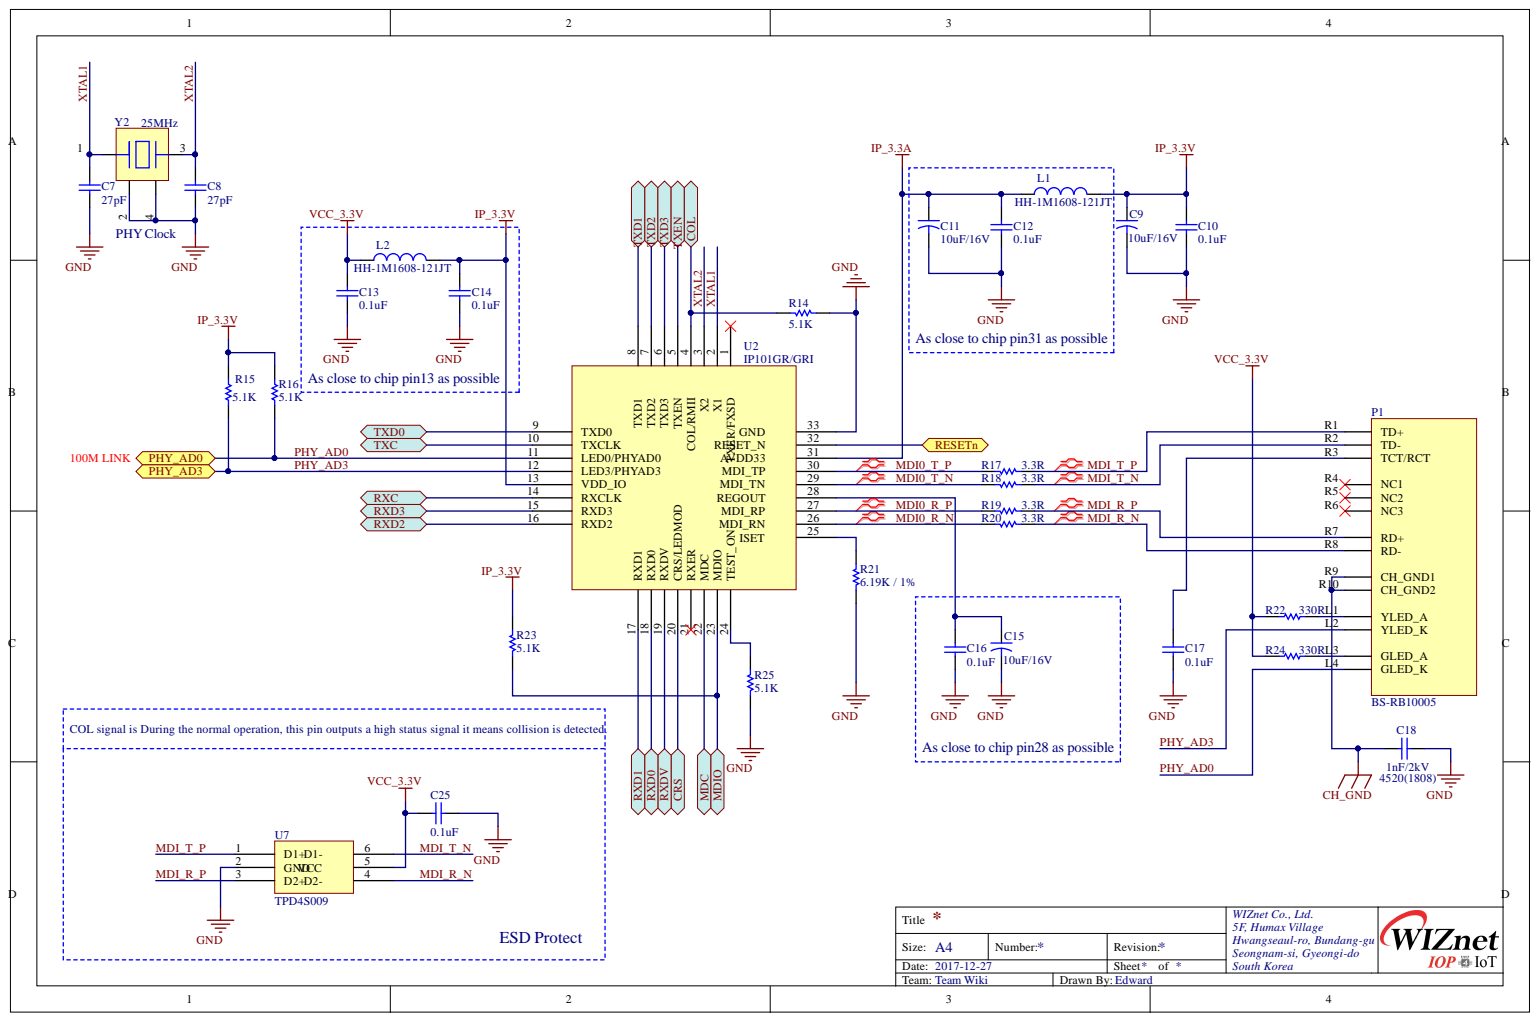
[picture p76: page 2]

As close to chip pin31 as possible

TXER/FXSD 1 X1 2 X2 3 COL/RMII 4 TXEN 5 TXD3 6 TXD2 7 TXD1 8

TD- R2
TCT/RCT R3

CH_GND1 R9
CH_GND2 R10

YLED_K L2 YLED_A L1

COL signal is During the normal operation, this pin outputs a high status signal it means collision is detected.

As close to chip pin28 as possible

* Title | WIZnet Co., Ltd. 5F, Humax Village Hwangseaul-ro, Bundang-gu Seongnam-si, Gyeongi-do

A4 Size: | * Number: | * Revision:

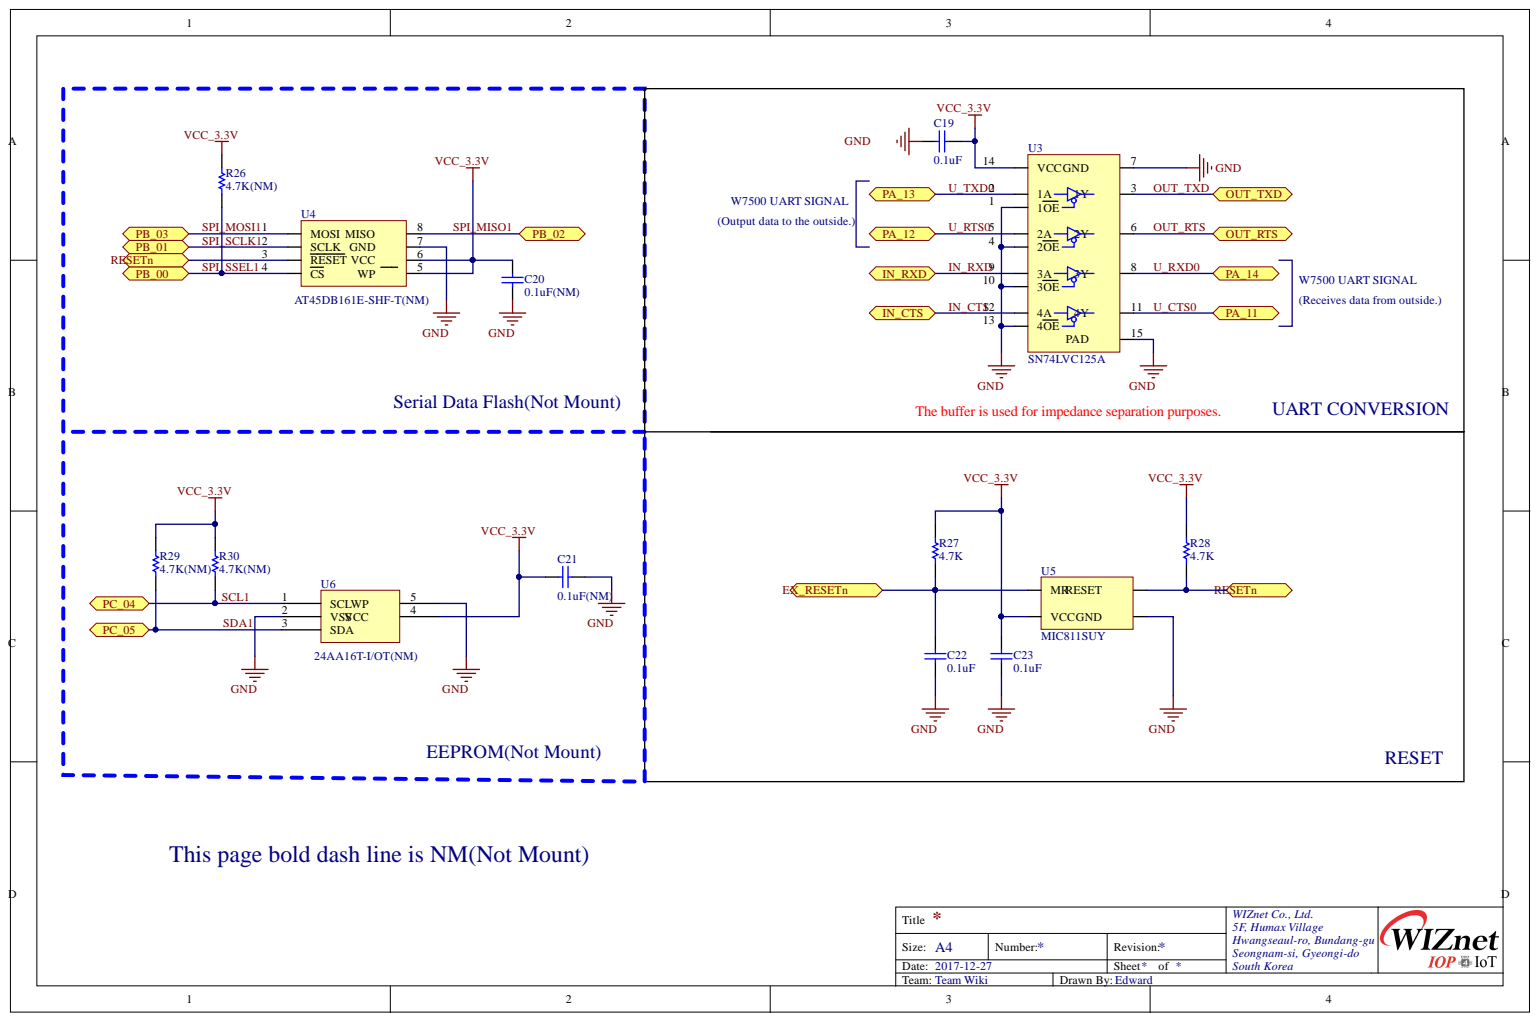
[picture p77: page 3]

W7500 UART SIGNAL
(Output data to the outside.)

(Receives data from outside.)

Serial Data Flash(Not Mount)

This page bold dash line is NM(Not Mount)

* Title | WIZnet Co., Ltd. 5F, Humax Village Hwangseaul-ro, Bundang-gu Seongnam-si, Gyeongi-do

A4 Size: | * Number: | * Revision:

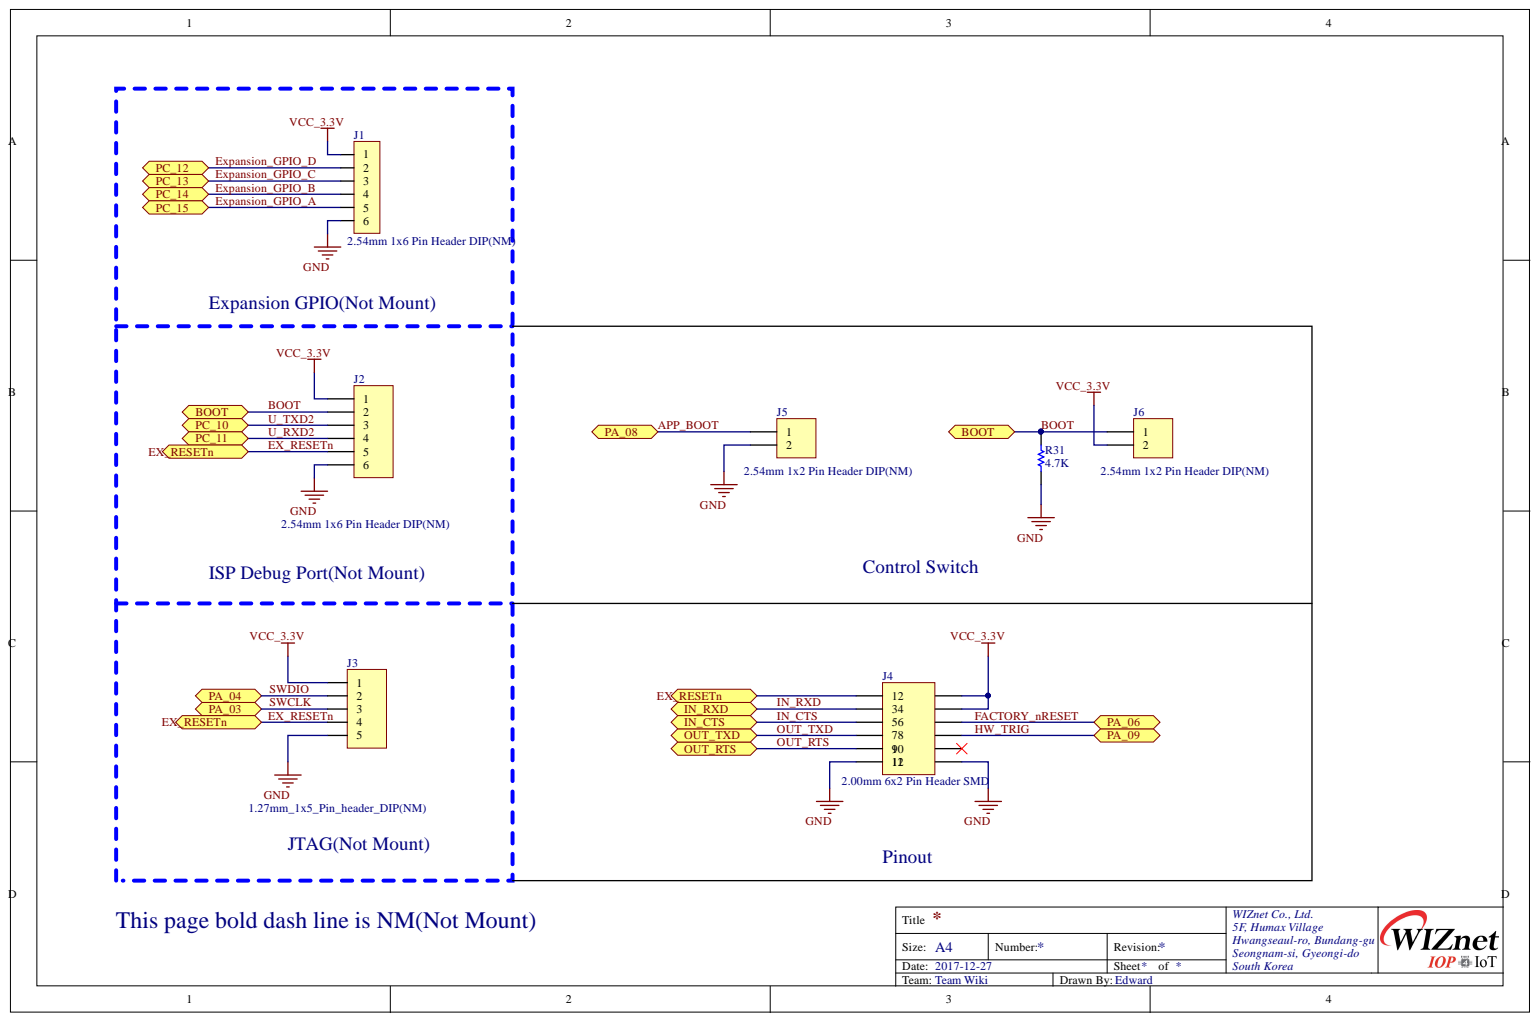
[picture p78: page 4]

Expansion GPIO(Not Mount)

2.54mm 1x2 Pin Header DIP(NM)

GND
2.54mm 1x6 Pin Header DIP(NM)

ISP Debug Port(Not Mount)

This page bold dash line is NM(Not Mount)

* Title | WIZnet Co., Ltd. 5F, Humax Village Hwangseaul-ro, Bundang-gu Seongnam-si, Gyeongi-do

A4 Size: | * Number: | * Revision:
