bjnhur/WIZpm/01.Serial_to_ethernet_module/02.WIZ750SR-EVB/01.Hardware/01.Schematic/01.WIZ750SR-EVB(TTL_RS232)_SCH_V100/WIZ750SR-EVB(TTL_RS232)_SCH_V100.pdf

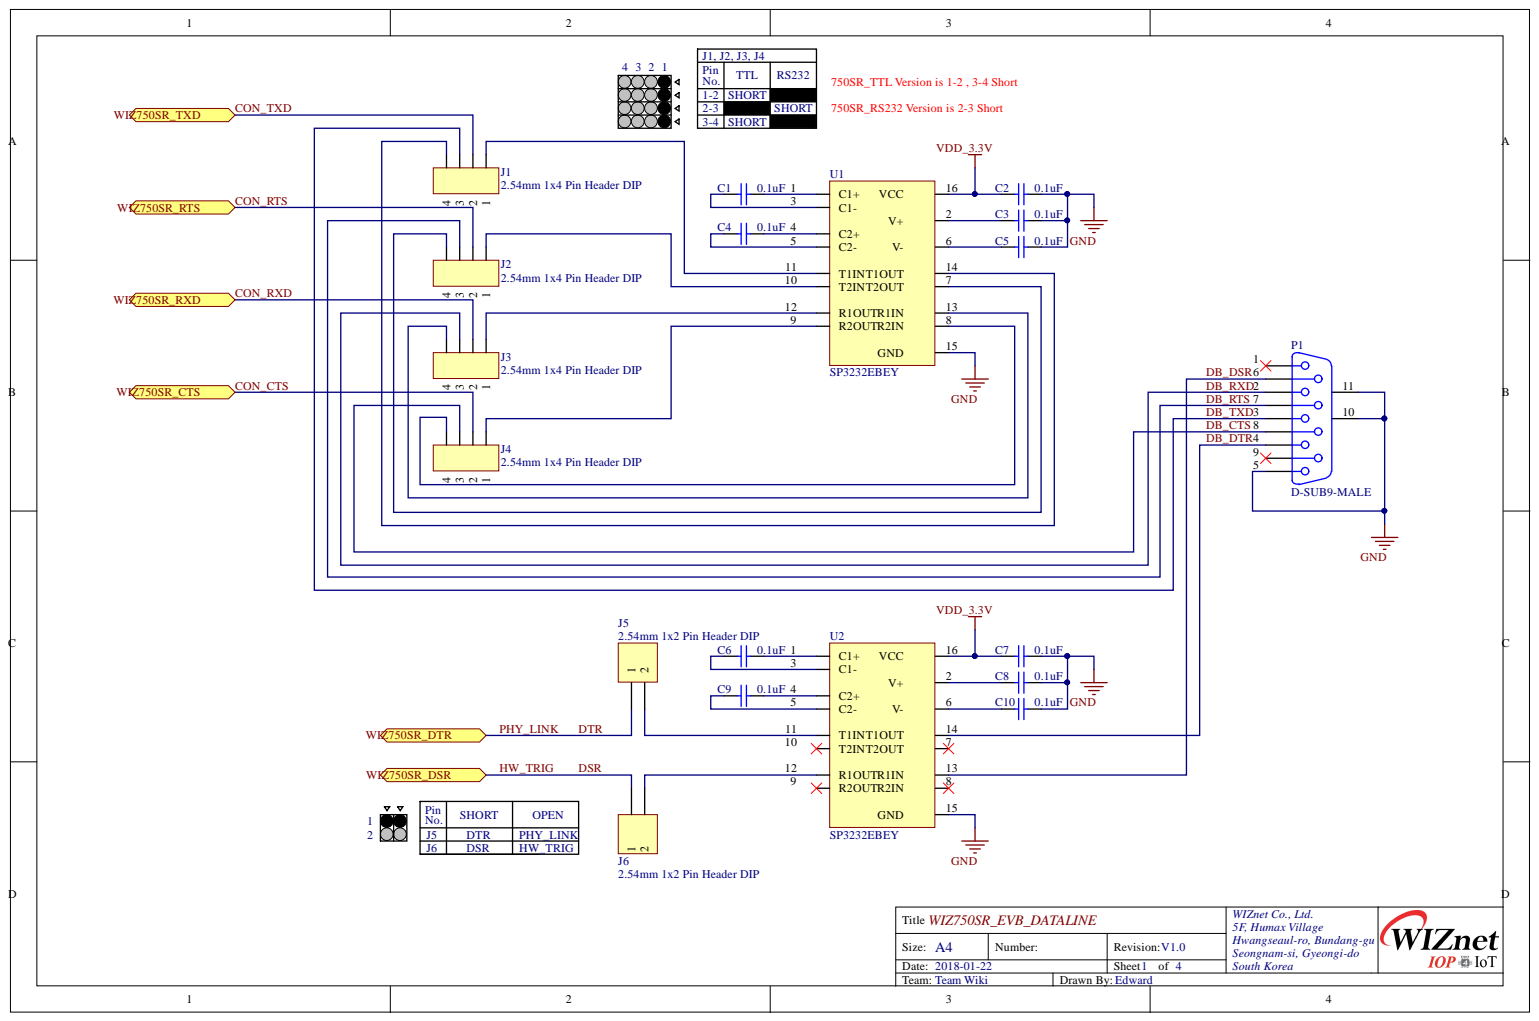
[picture p83: page 1]

n . N o | T T L | RS2 3 2
1-2 2-3 3-4 | | SH O RT

PH Y _ LIN K | | 1 1 | 1 4

Pi n N o . | SH O RT | OPE N

J 5 | D T R | PH Y _ LIN K
J 6 | DSR | H W _ TRIG

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

A4 Team Size: | N umber: | Rev i s i o n : V 1.0

8-0 1-2 | | Sheet o f
W i k i | Draw n By : E d ward

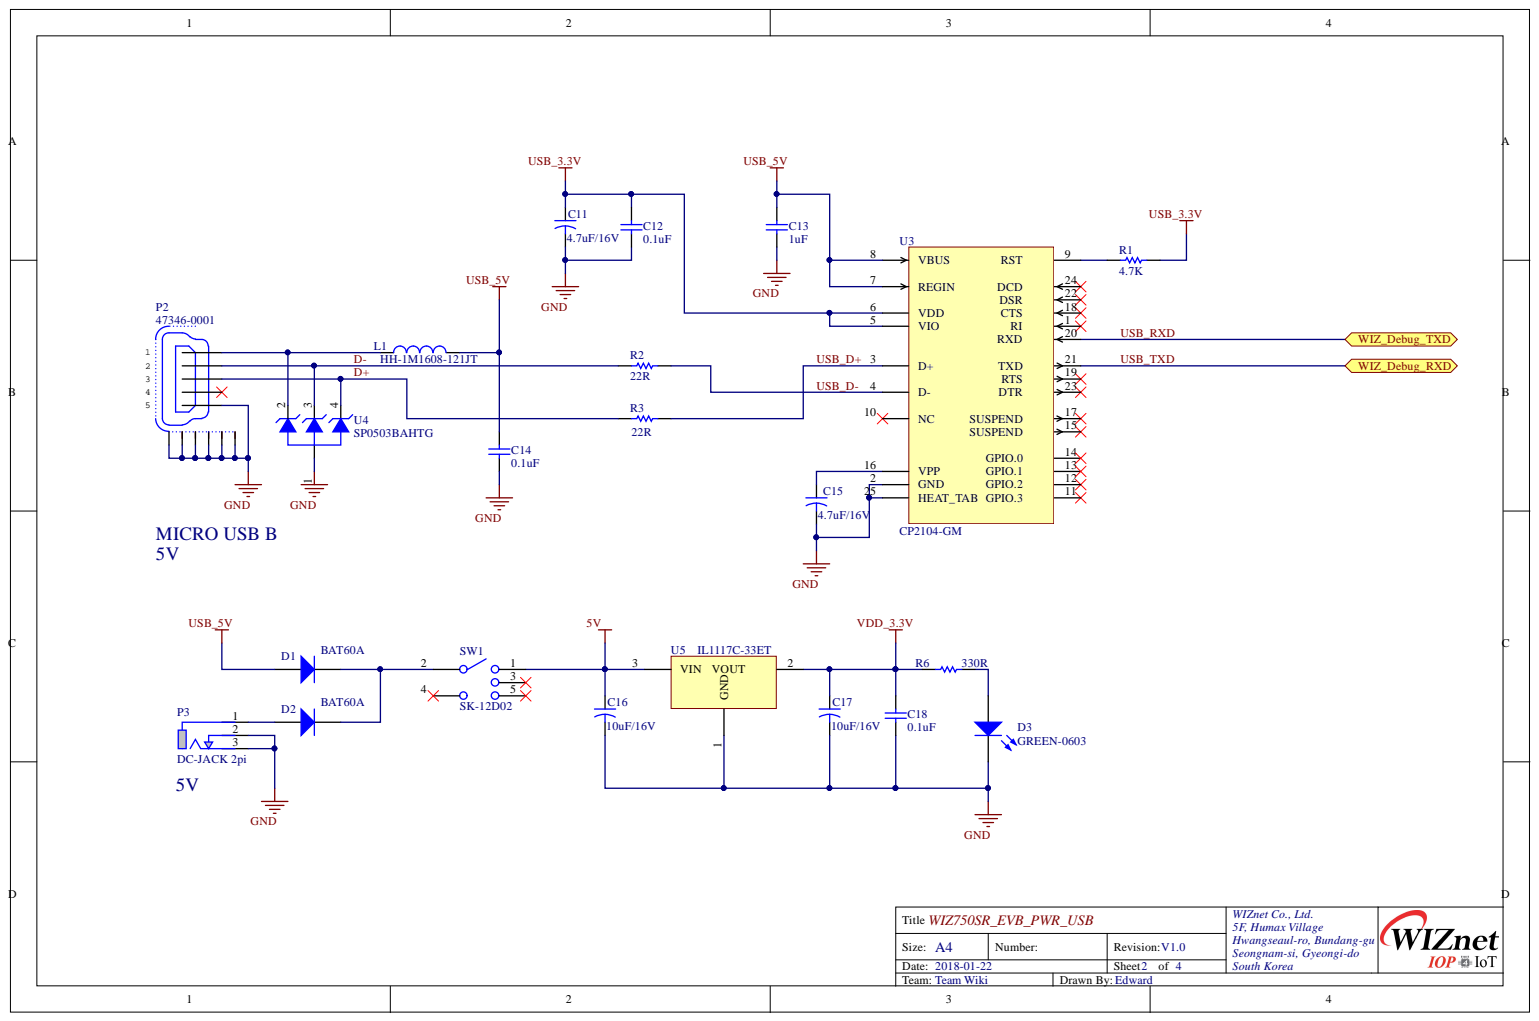
[picture p84: page 2]

D-
D+

Title WIZ750SR_EVB_PWR_USB | WIZnet Co., Ltd. 5F, Humax Village Hwangseaul-ro, Bundang-gu Seongnam-si, Gyeongi-do South Korea

A4 Size: | Number: | Revision: V1.0
Date: 2018-01-22 | | Sheet of 4
Team: Team Wiki | Drawn By: Edward

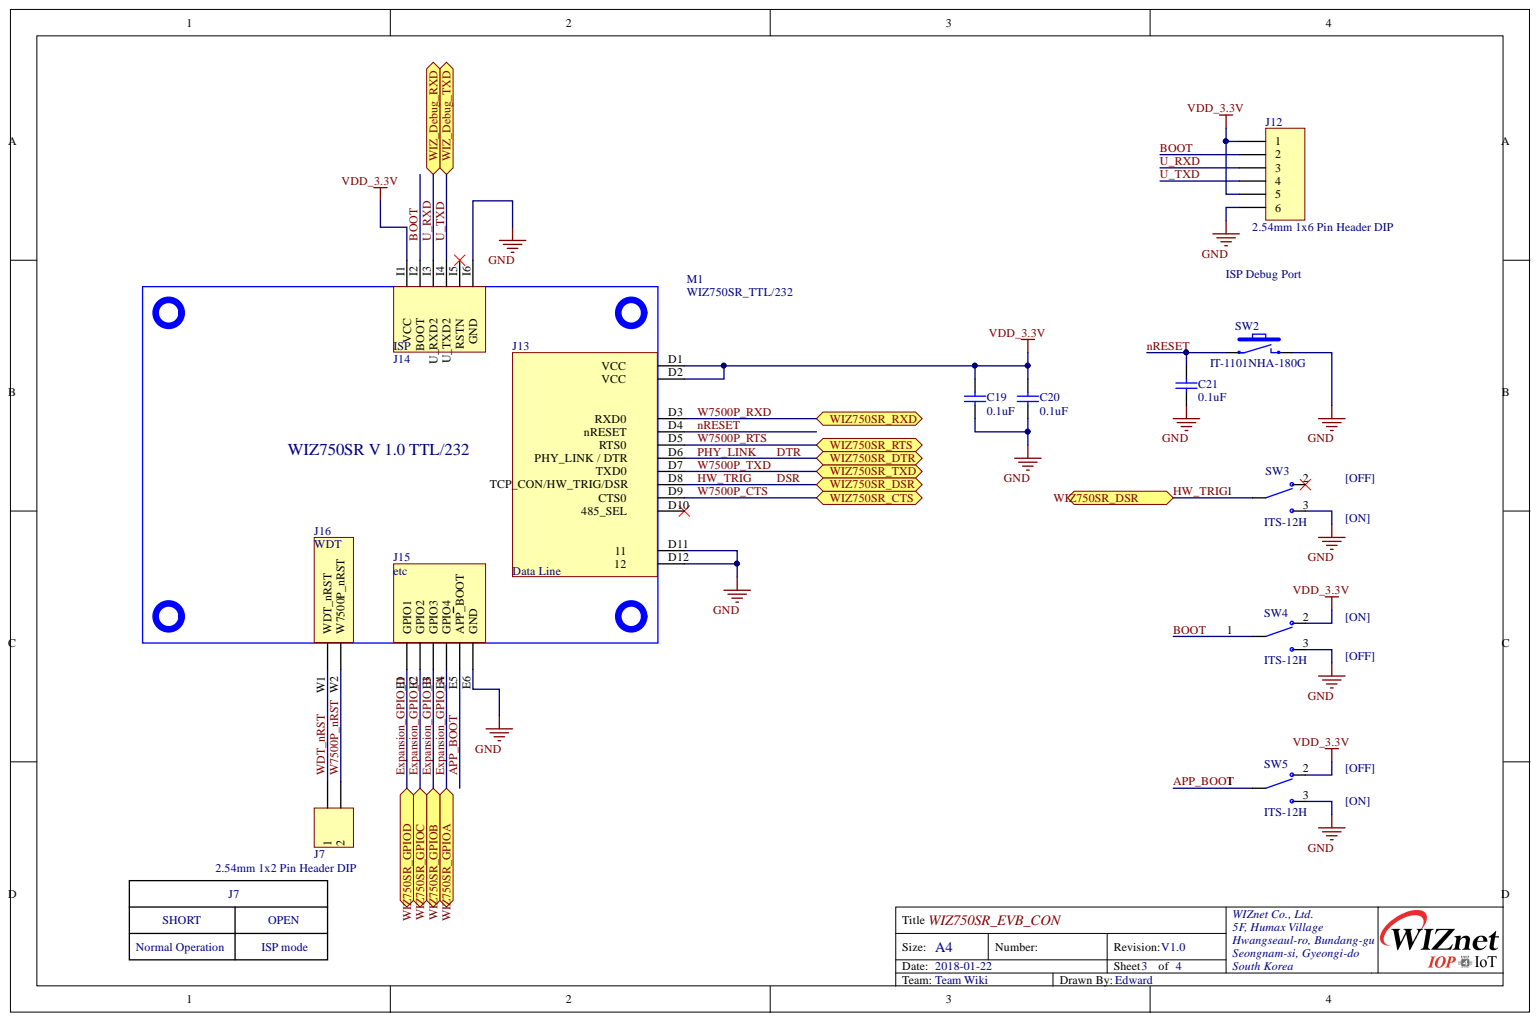
[picture p85: page 3]

GND E6 APP_BOOT E5 GPIO4 E4 GPIO3 E3 GPIO2 E2 GPIO1 E1 VCC I1 BOOT I2 U_RXD2 I3 U_TXD2 I4 RSTN I5 GND I6

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

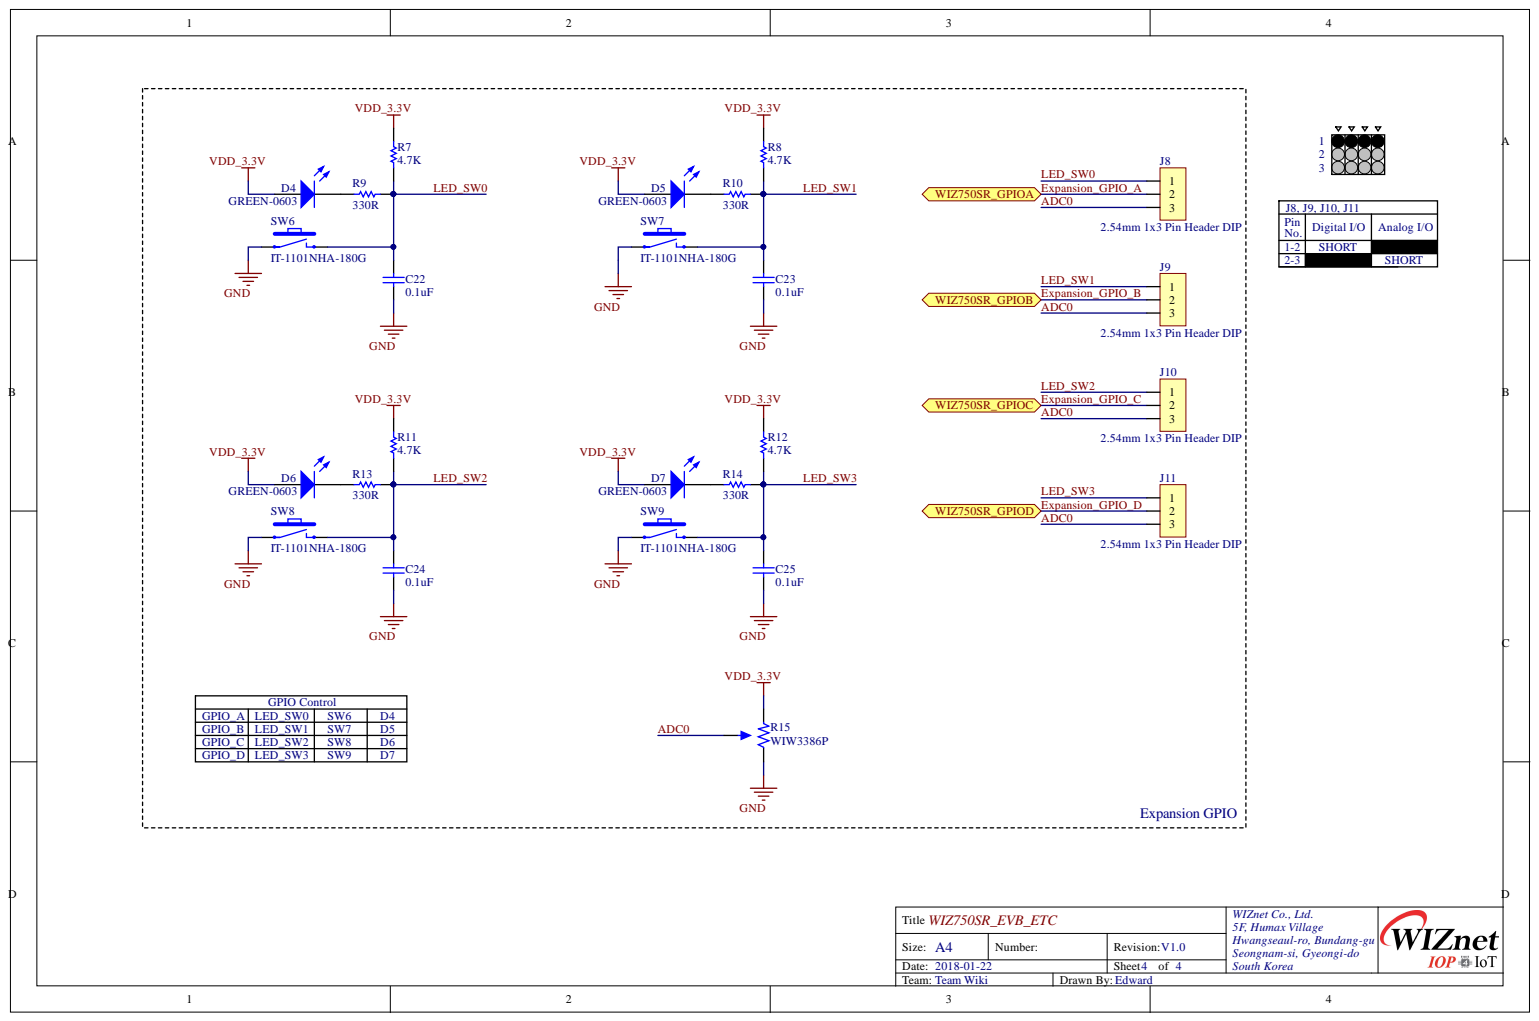
[picture p86: page 4]

Pin No. | Digital I/O | Analog I/O

1-2 | SHORT
2-3 | | SHORT

GPIO_A | LED_SW0 | SW6 | D4
GPIO_B | LED_SW1 | SW7 | D5
GPIO_C | LED_SW2 | SW8 | D6
GPIO_D | LED_SW3 | SW9 | D7

Title WIZ750SR_EVB_ETC | WIZnet Co., Ltd. 5F, Humax Village Hwangseaul-ro, Bundang-gu Seongnam-si, Gyeongi-do South Korea

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
