bjnhur/WIZpm/01.Serial_to_ethernet_module/02.WIZ750SR-EVB/01.Hardware/01.Schematic/02.WIZ750SR-EVB(RS422_485)_SCH_V100/WIZ750SR-EVB(RS422_485)_SCH_V100.pdf

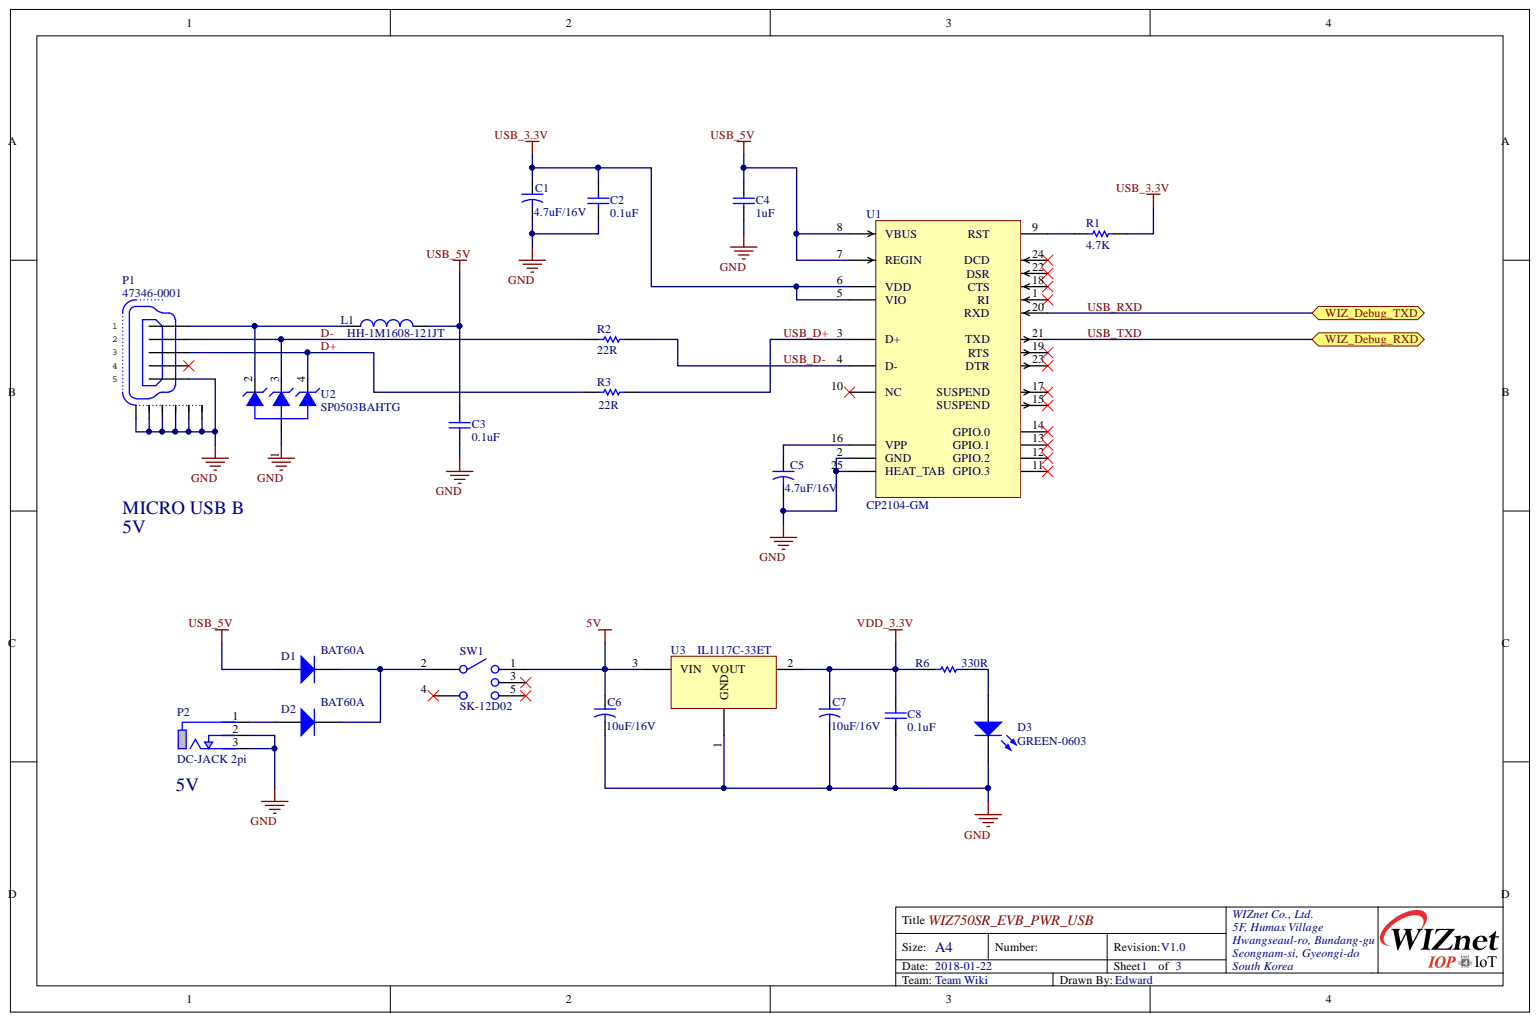
[picture p87: page 1]

Title WIZ750SR_EVB_PWR_USB | WIZnet Co., Ltd. 5F, Humax Village Hwangseaul-ro, Bundang-gu Seongnam-si, Gyeongi-do South Korea

A4 Size: | Number: | Revision: V1.0
Date: 2018-01-22 | | Sheet of 3
Team: Team Wiki | Drawn By: Edward

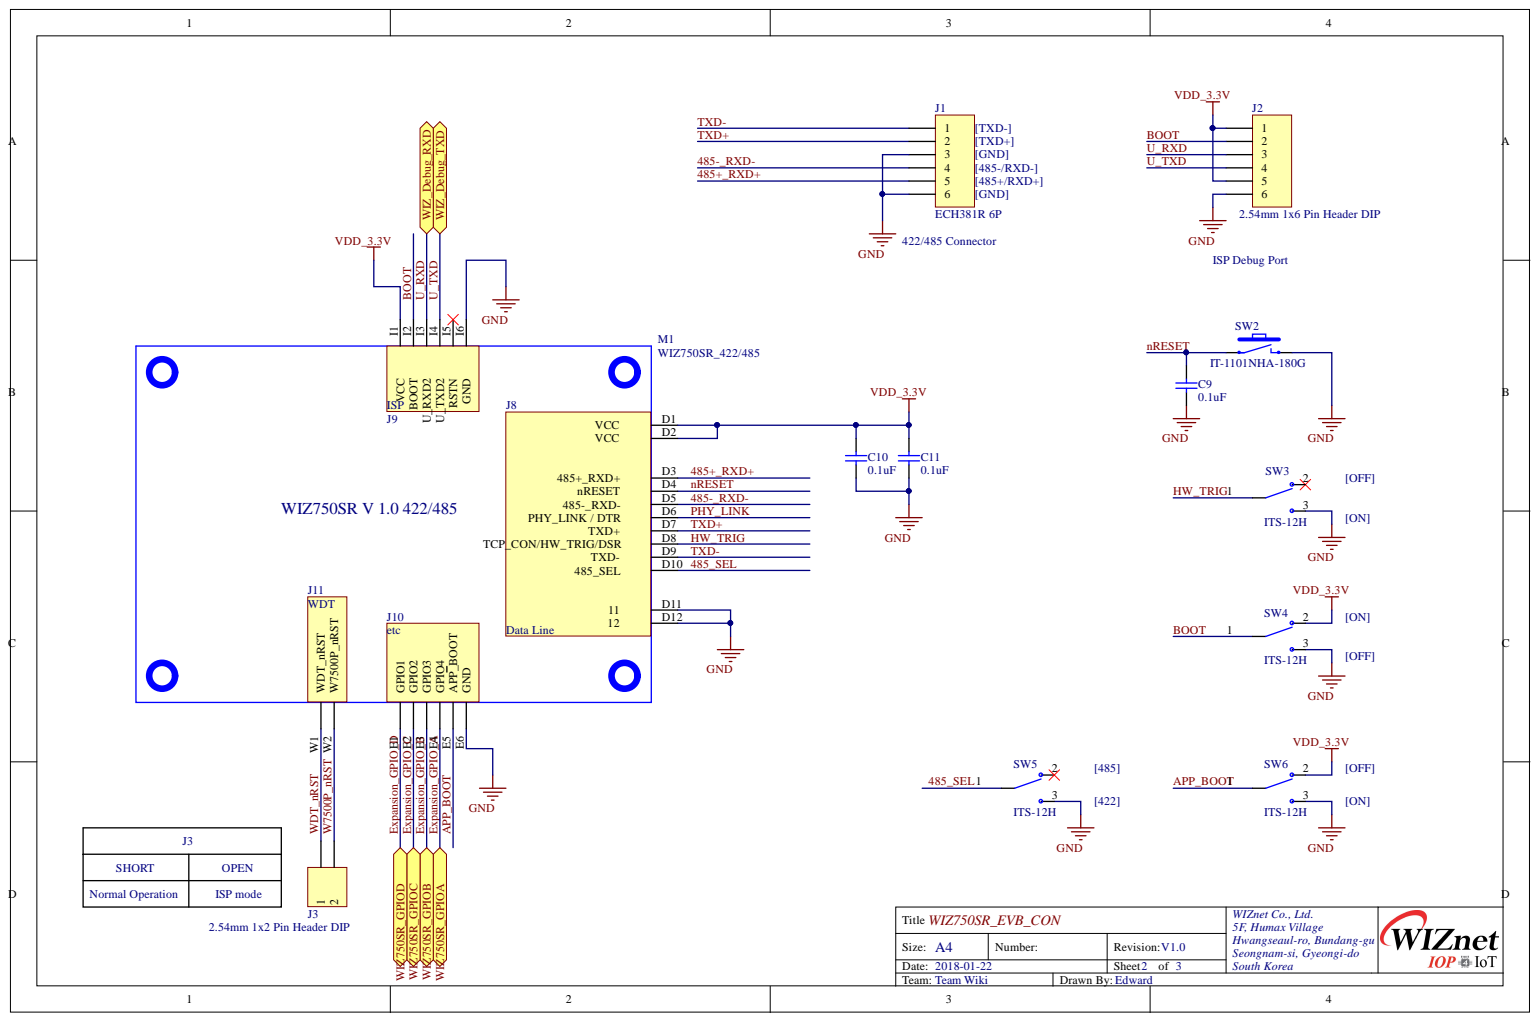
[picture p88: page 2]

GND E6 APP_BOOT E5 GPIO4 E4 GPIO3 E3 GPIO2 E2 GPIO1 E1 VCC I1 BOOT I2 U_RXD2 I3 U_TXD2 I4 RSTN I5 GND I6

SH O RT | OPE N

N ormal O perat i o n | ISP mo d e

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

A4 Team Size: | N umber: | Rev i s i o n : V 1.0

8-0 1-2 | | Sheet o f
W i k i | Draw n By : E d ward

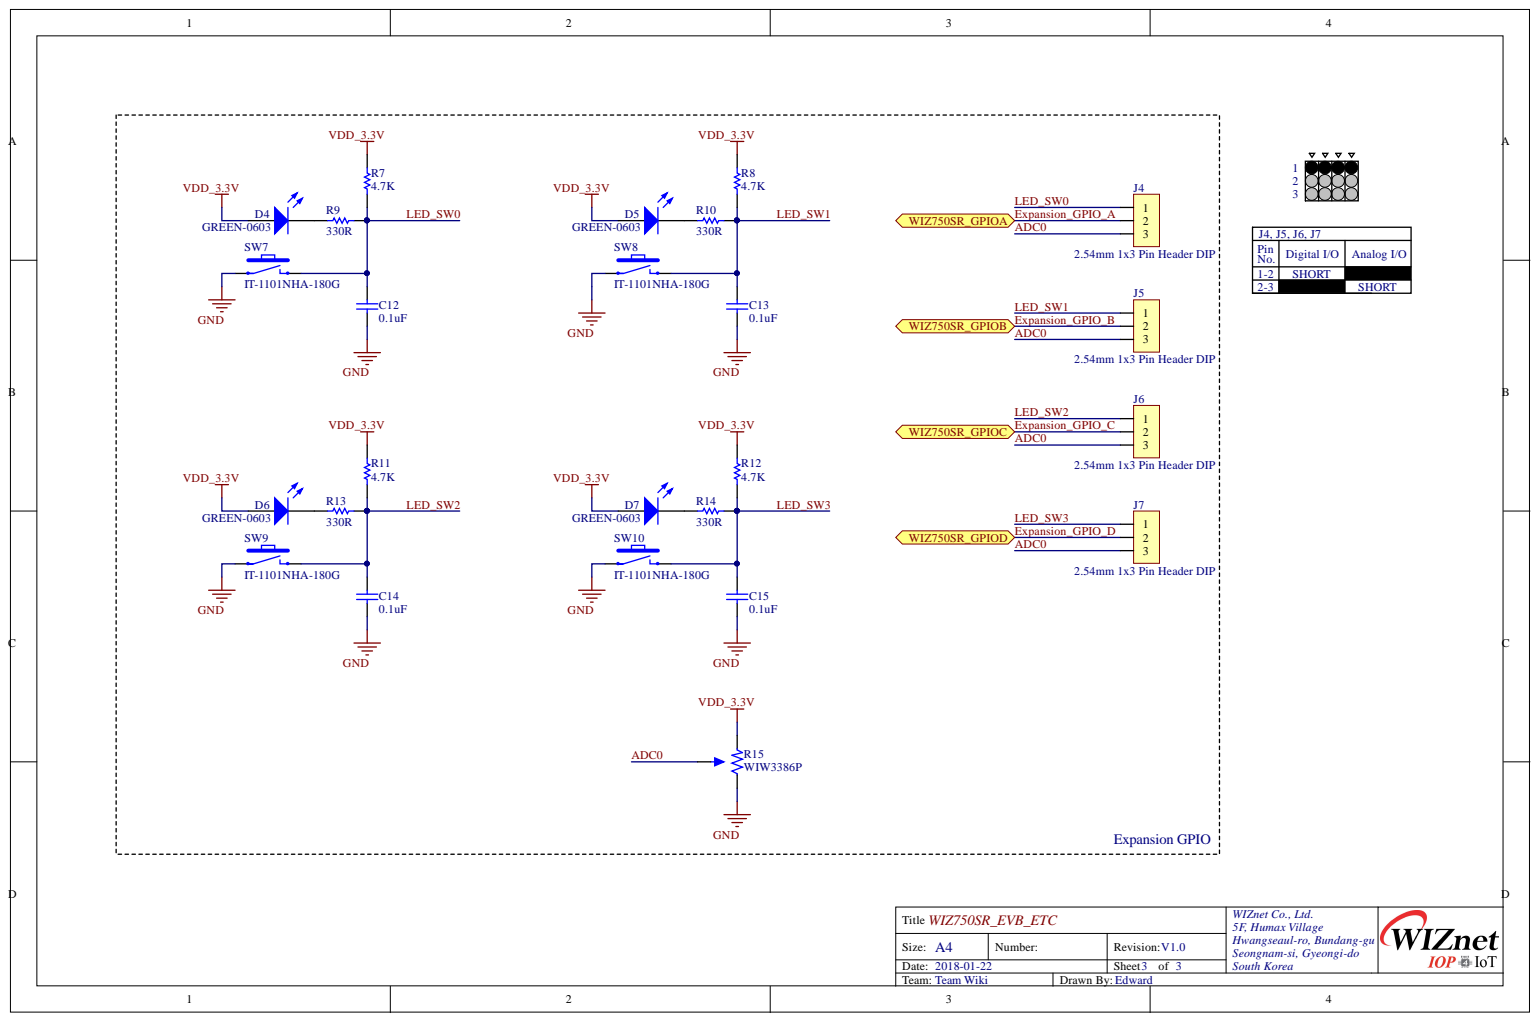
[picture p89: page 3]

Pin No. | Digital I/O | Analog I/O

1-2 | SHORT
2-3 | | SHORT

Title WIZ750SR_EVB_ETC | WIZnet Co., Ltd. 5F, Humax Village Hwangseaul-ro, Bundang-gu Seongnam-si, Gyeongi-do South Korea

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
