bjnhur/WIZpm/01.Serial_to_ethernet_module/01.WIZ750SR/WIZ750SR_V110/01.Hardware/01.Schematic/WIZ750SR_SCH_V110.pdf

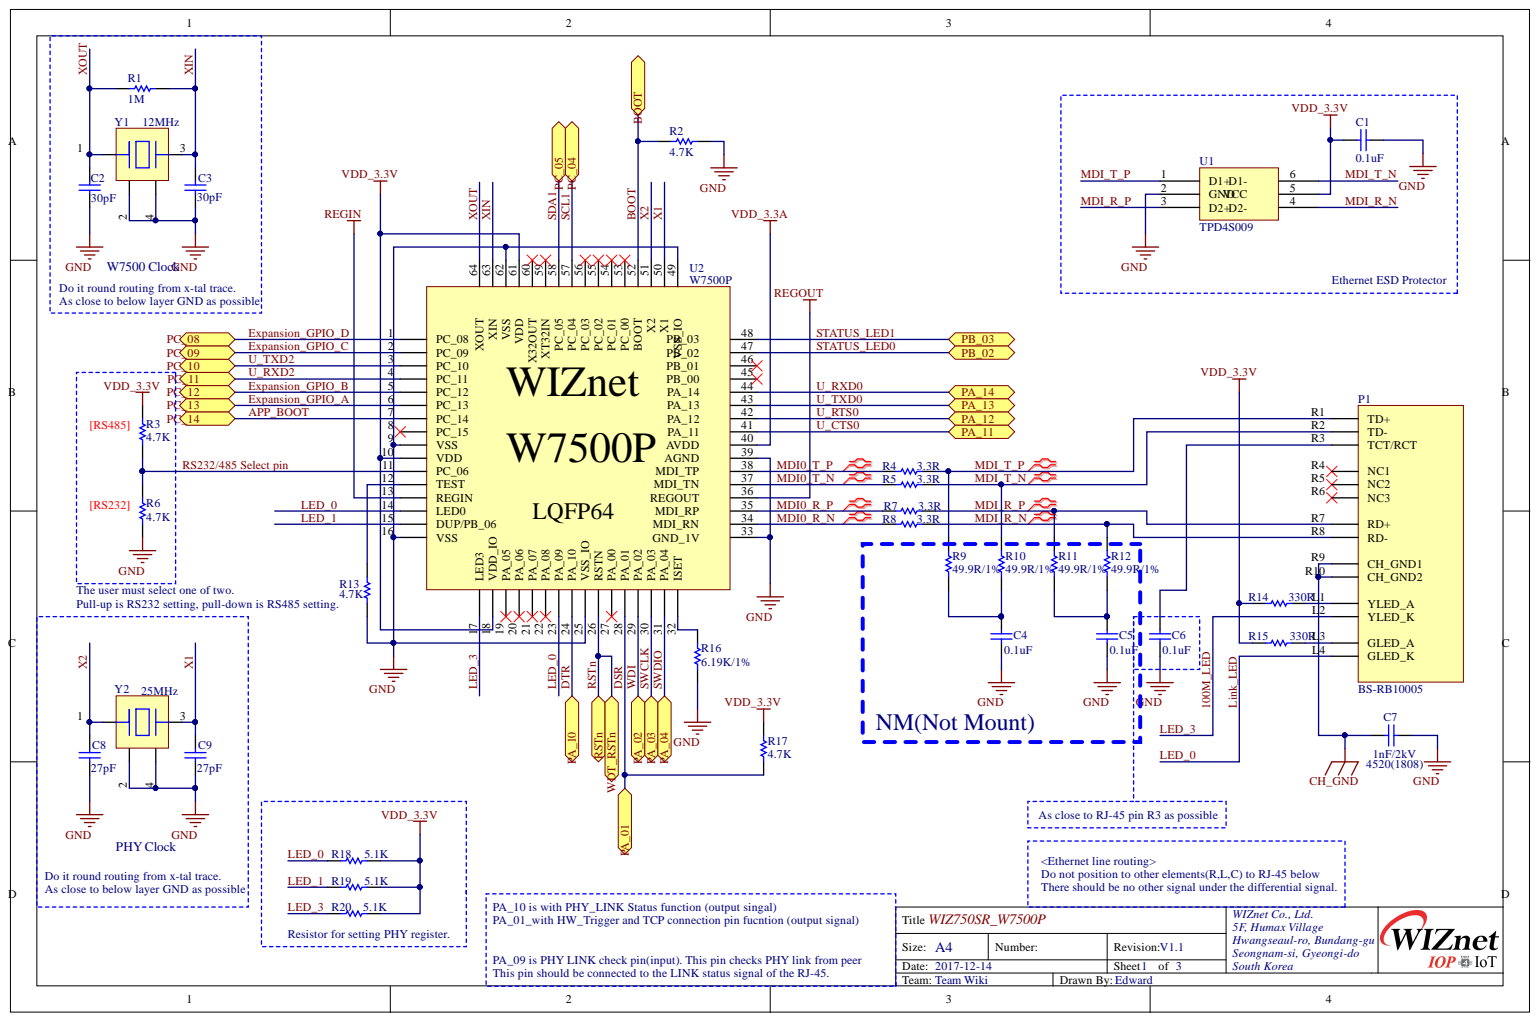
[picture p90: page 1]

VSS_IO 49 X1 50 X2 51 BOOT 52 PC_00 53 PC_01 54 PC_02 55 PC_03 56 PC_04 57 PC_05 58 XT32IN 59 X32OUT 60 VDD 61 VSS 62 XIN 63 XOUT 64

Do it round routing from x-tal trace.
As close to below layer GND as possible

U_TXD0
U_RTS0
U_CTS0 | TD- R2

VSS 9 | | | | TCT/RCT R3

REGIN 13

CH_GND1 R9
CH_GND2 R10

The user must select one of two.
Pull-up is RS232 setting, pull-down is RS485 setting.

YLED_K L2 YLED_A L1

As close to RJ-45 pin R3 as possible

<Ethernet line routing>
Do not position to other elements(R,L,C) to RJ-45 below
There should be no other signal under the differential signal.

PA_10 is with PHY_LINK Status function (output singal)
PA_01_with HW_Trigger and TCP connection pin fucntion (output signal)

WIZ750SR_W7500P Title | WIZnet Co., Ltd. 5F, Humax Village Hwangseaul-ro, Bundang-gu Seongnam-si, Gyeongi-do South Korea

Resistor for setting PHY register.

PA_09 is PHY LINK check pin(input). This pin checks PHY link from peer
This pin should be connected to the LINK status signal of the RJ-45.

A4 Size: | Number: | Revision: V1.1
Date: 2017-12-14 | | Sheet of 3
Team: Team Wiki | Drawn By: Edward

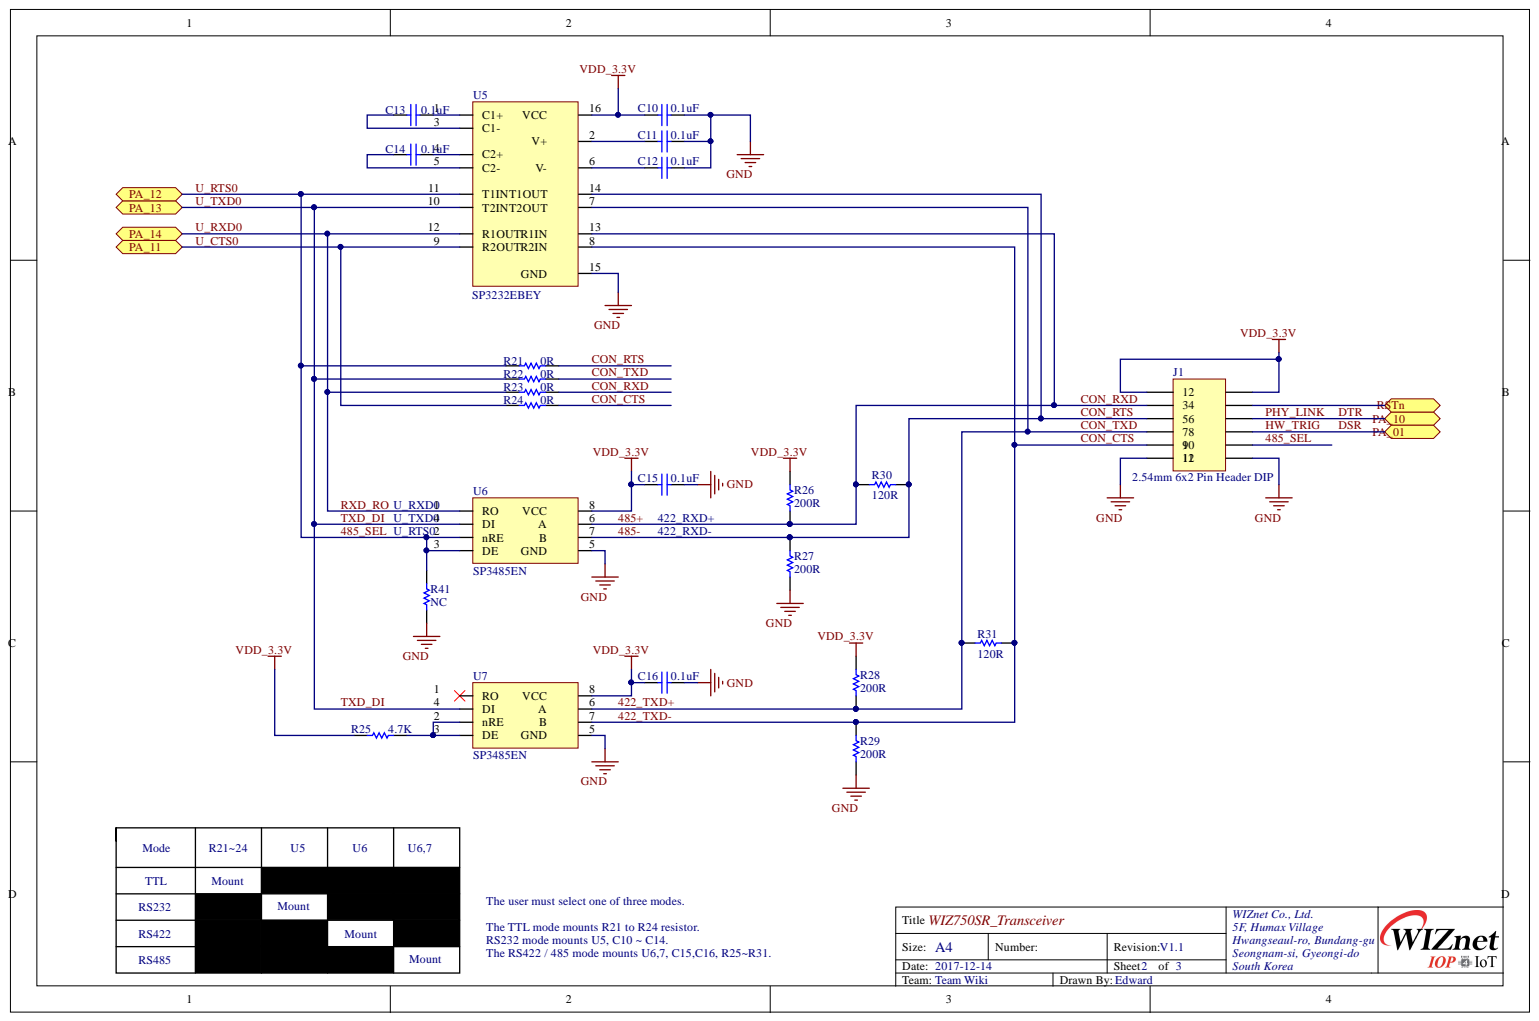
[picture p91: page 2]

CO N _ T X D
CO N _CT S

4 8 5 _SE L U _ RTS0 2 | | 7 4 8 5 -4 2 2 _RX D -

2 | 7 4 2 2 _ T X D -

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

A4 Team Size: | N umber: | Rev i s i o n : V 1.1

7-1 2-1 | | Sheet o f
W i k i | Draw n By : E d ward

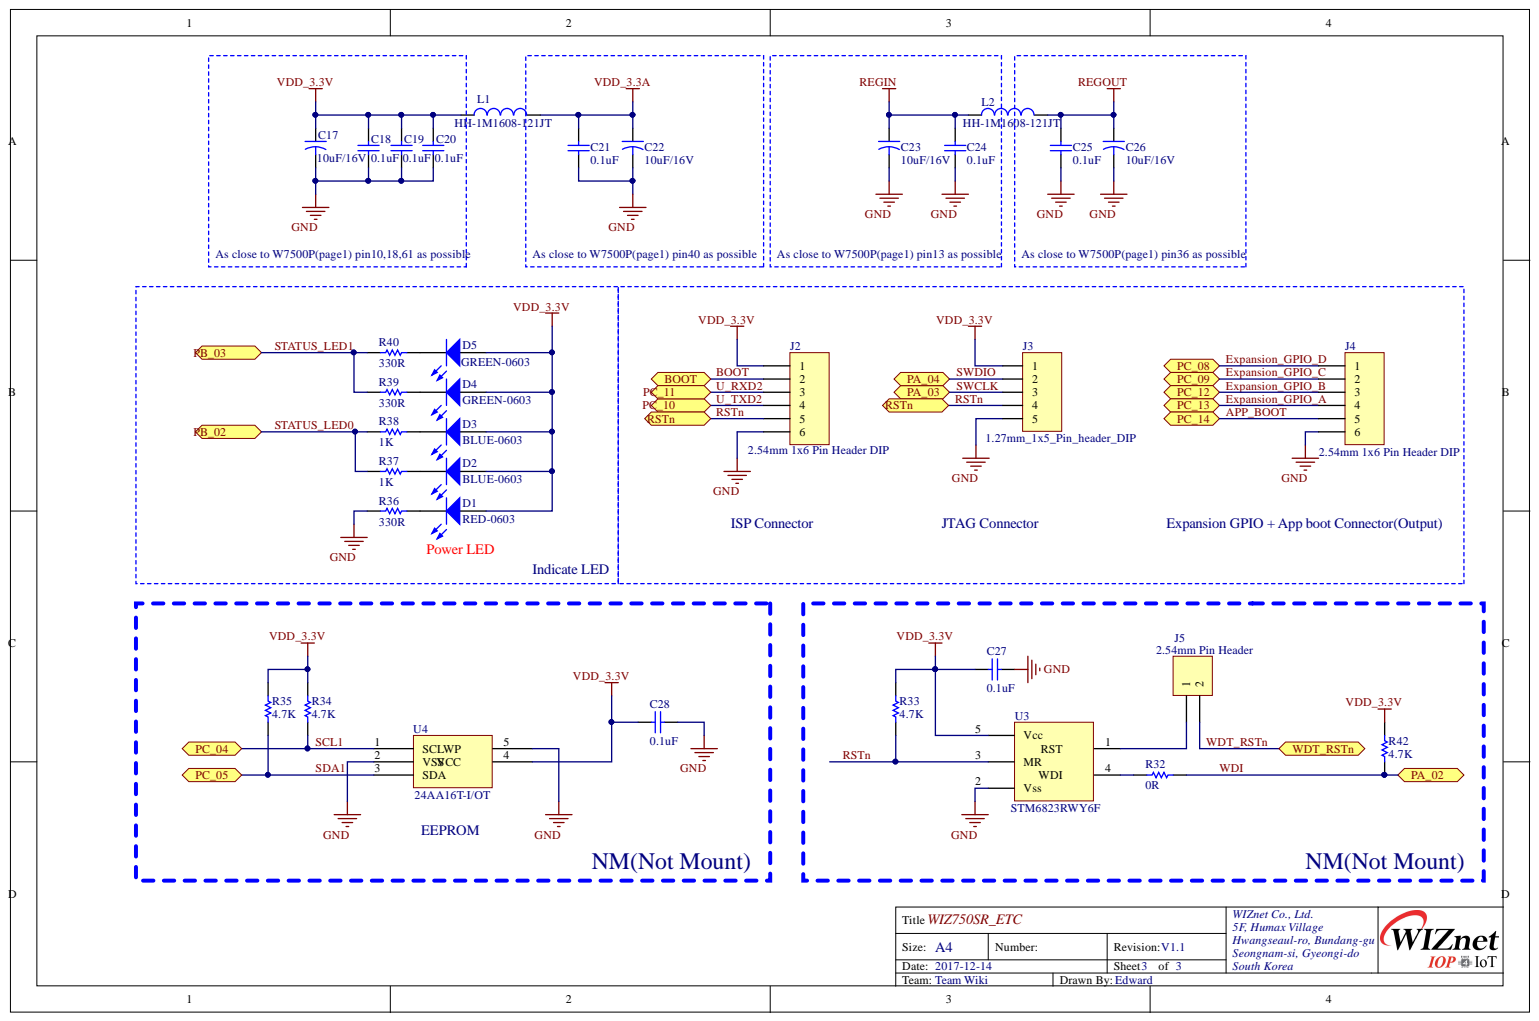
[picture p92: page 3]

WIZ750SR_ETC Title | WIZnet Co., Ltd. 5F, Humax Village Hwangseaul-ro, Bundang-gu Seongnam-si, Gyeongi-do South Korea

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
