bjnhur/WIZpm/01.Serial_to_ethernet_module/02.WIZ750SR-EVB/05.ETC/WIZ750SR_EVB_422_485.pdf

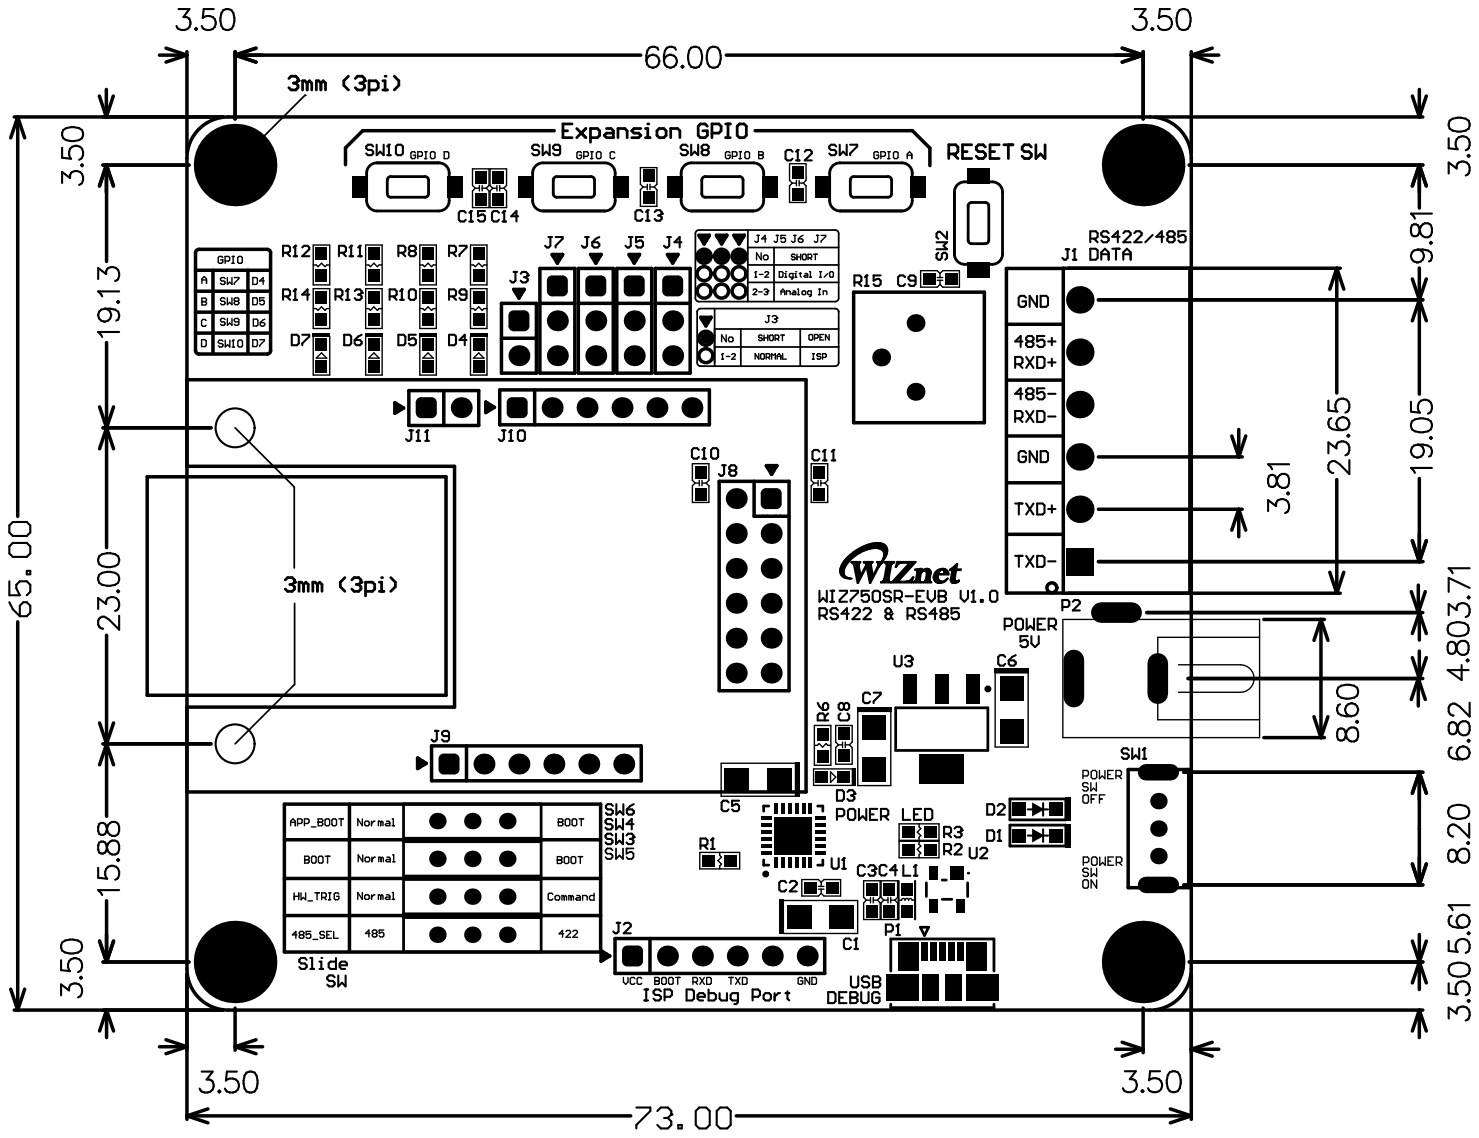
[picture p93: page 1]
