bjnhur/WIZpm/01.Serial_to_ethernet_module/02.WIZ750SR-EVB/05.ETC/WIZ750SR_EVB_RS232.pdf

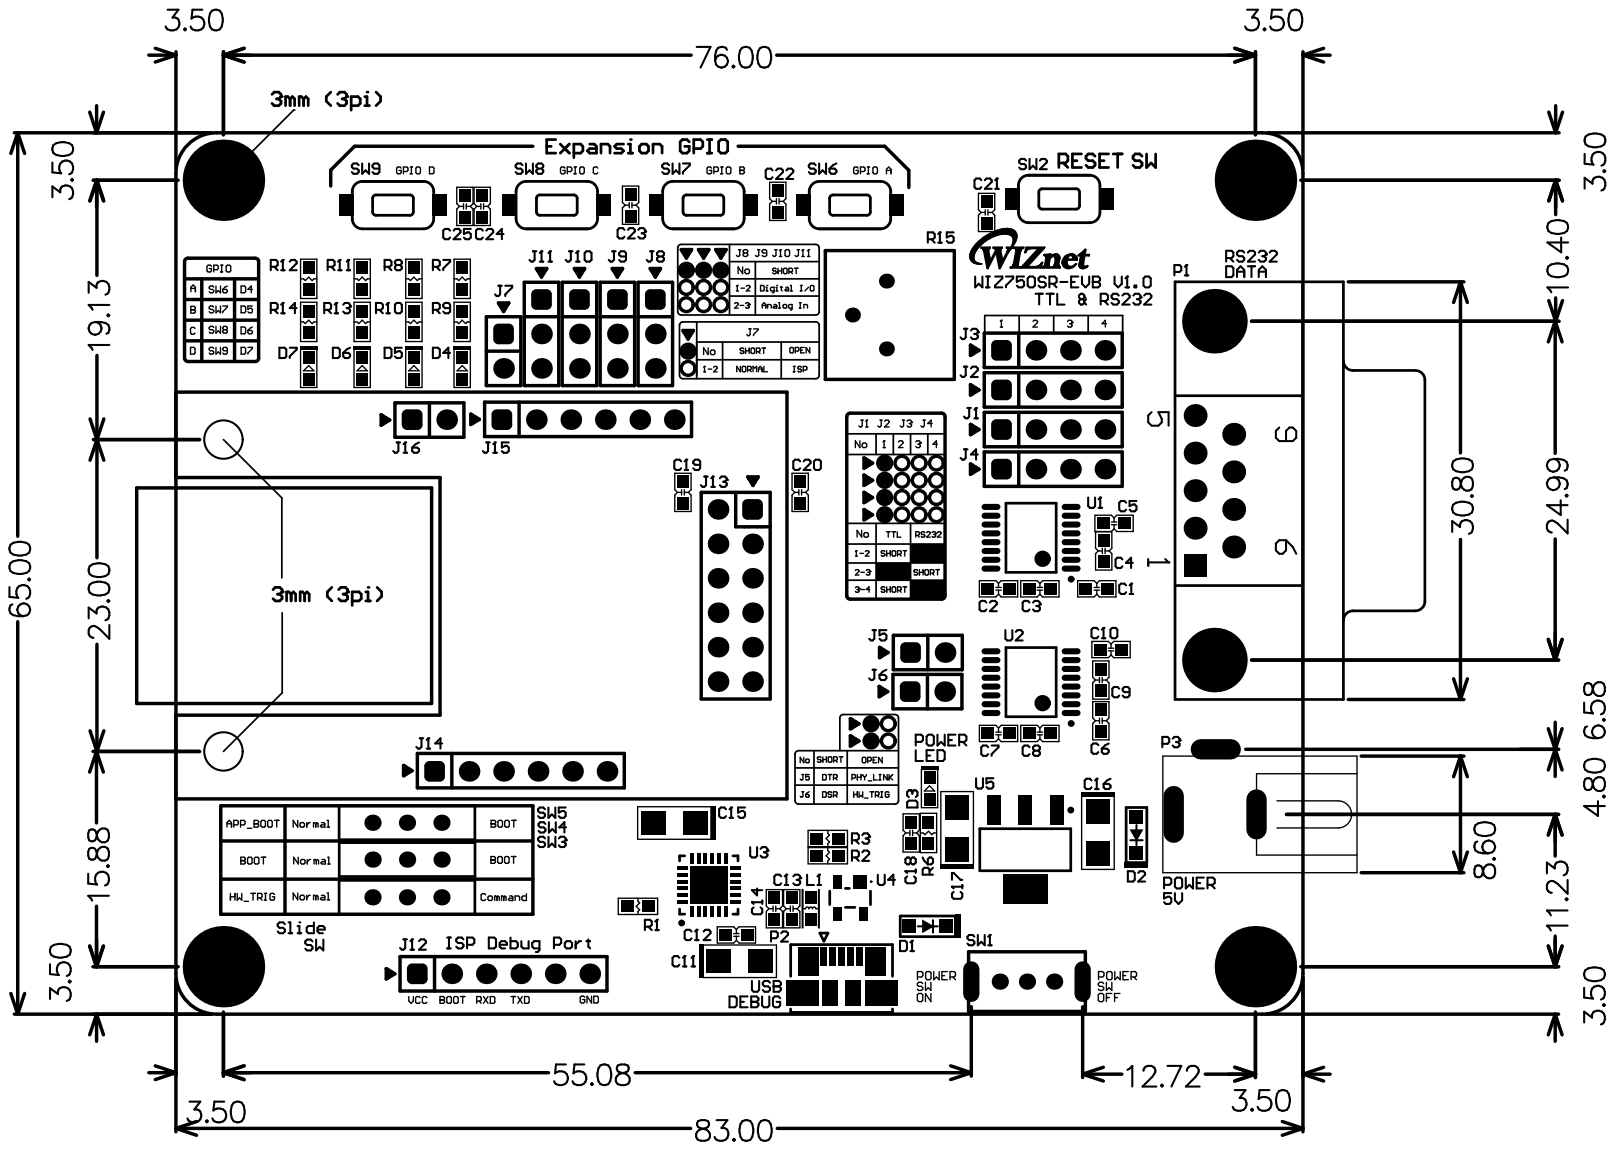
[picture p94: page 1]
