bjnhur/WIZpm/01.Serial_to_ethernet_module/03.WIZ750SR-100/05.ETC/WIZ750SR-100_V1.0_Dimension.pdf

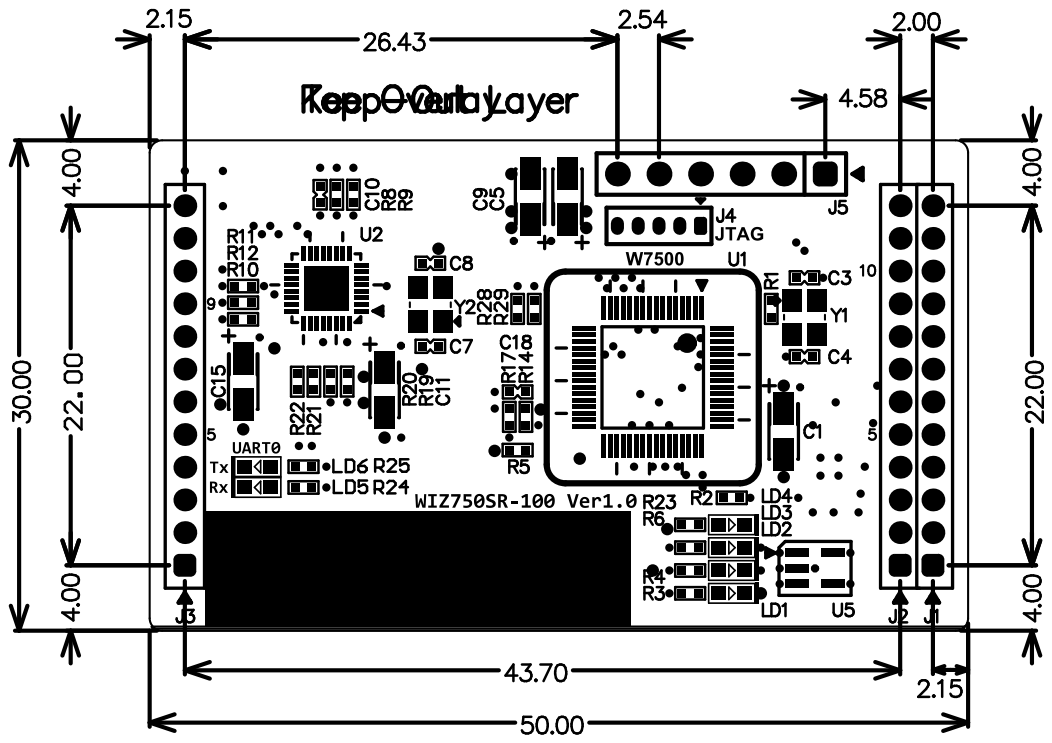
[picture p95: page 1]
