bjnhur/WIZpm/01.Serial_to_ethernet_module/04.WIZ750SR-100-EVB/05.ETC/WIZ750SR-100-EVB.pdf

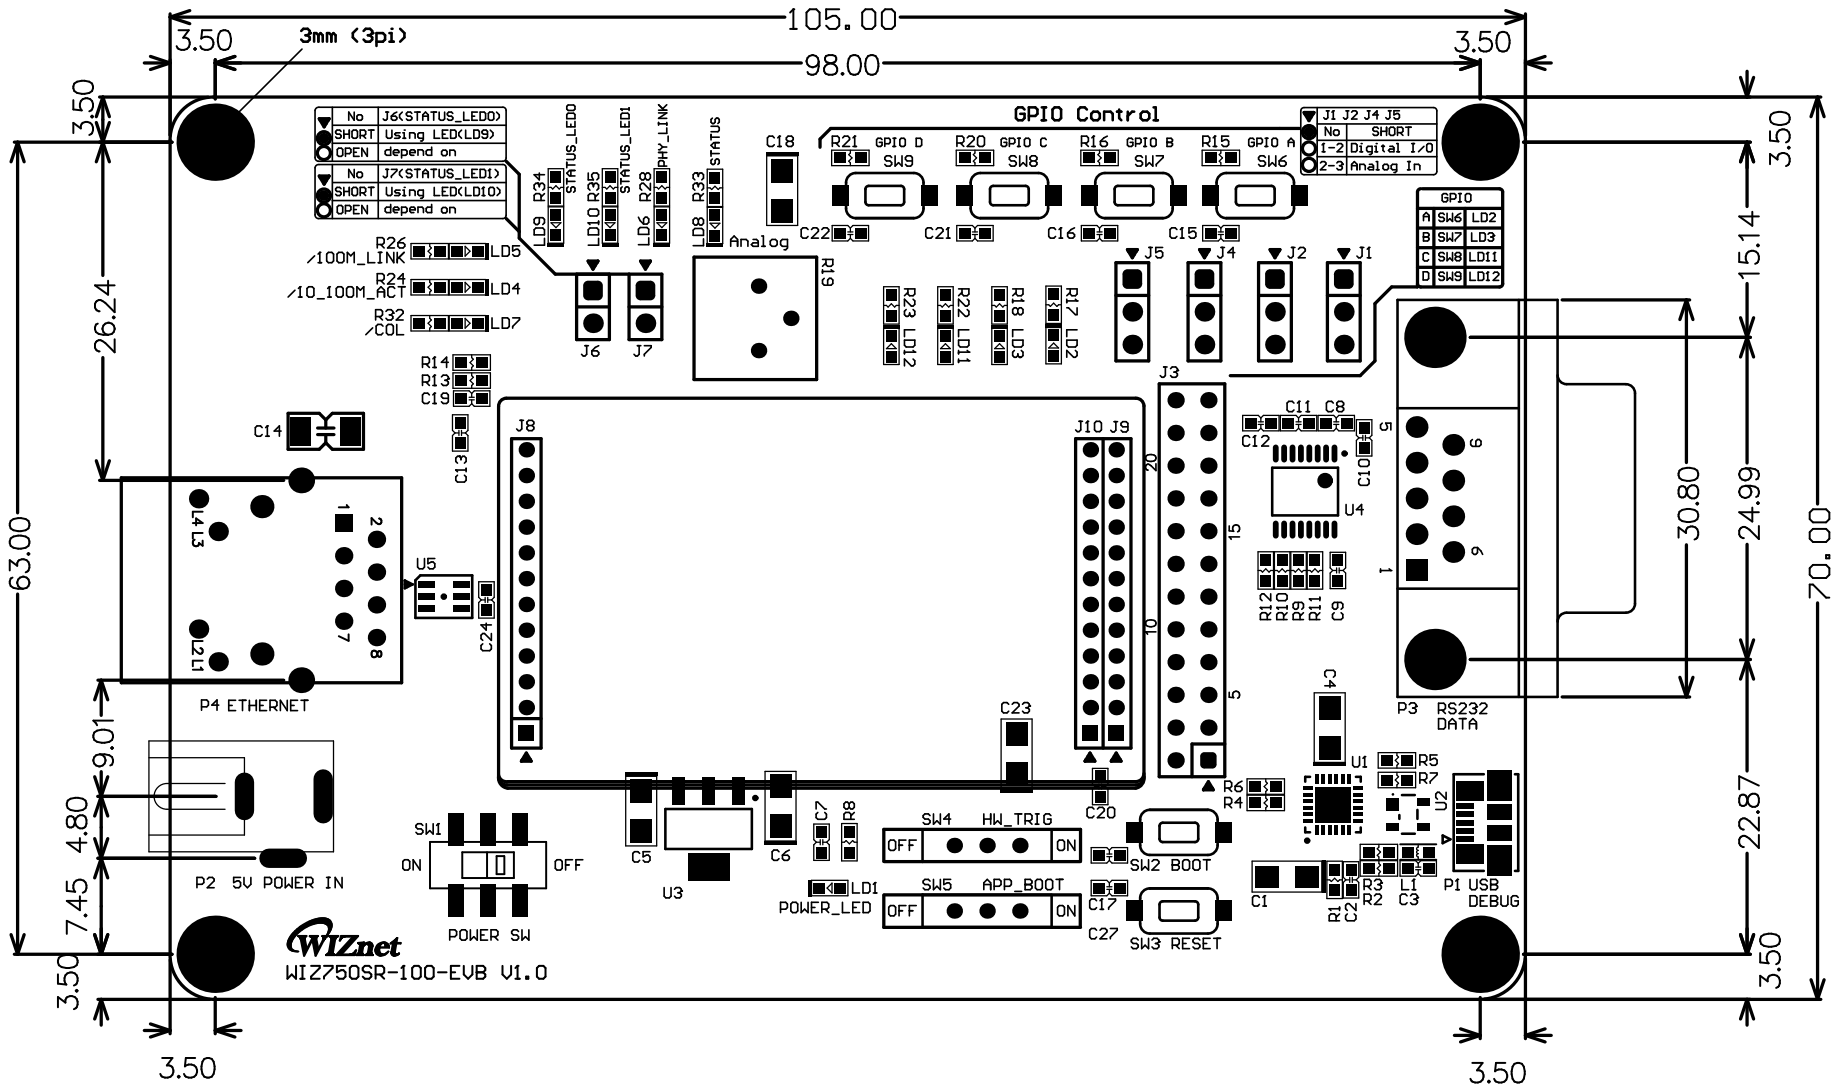
[picture p96: page 1]
