bjnhur/WIZpm/01.Serial_to_ethernet_module/05.WIZ750SR-105/05.ETC/WIZ750SR-105.pdf

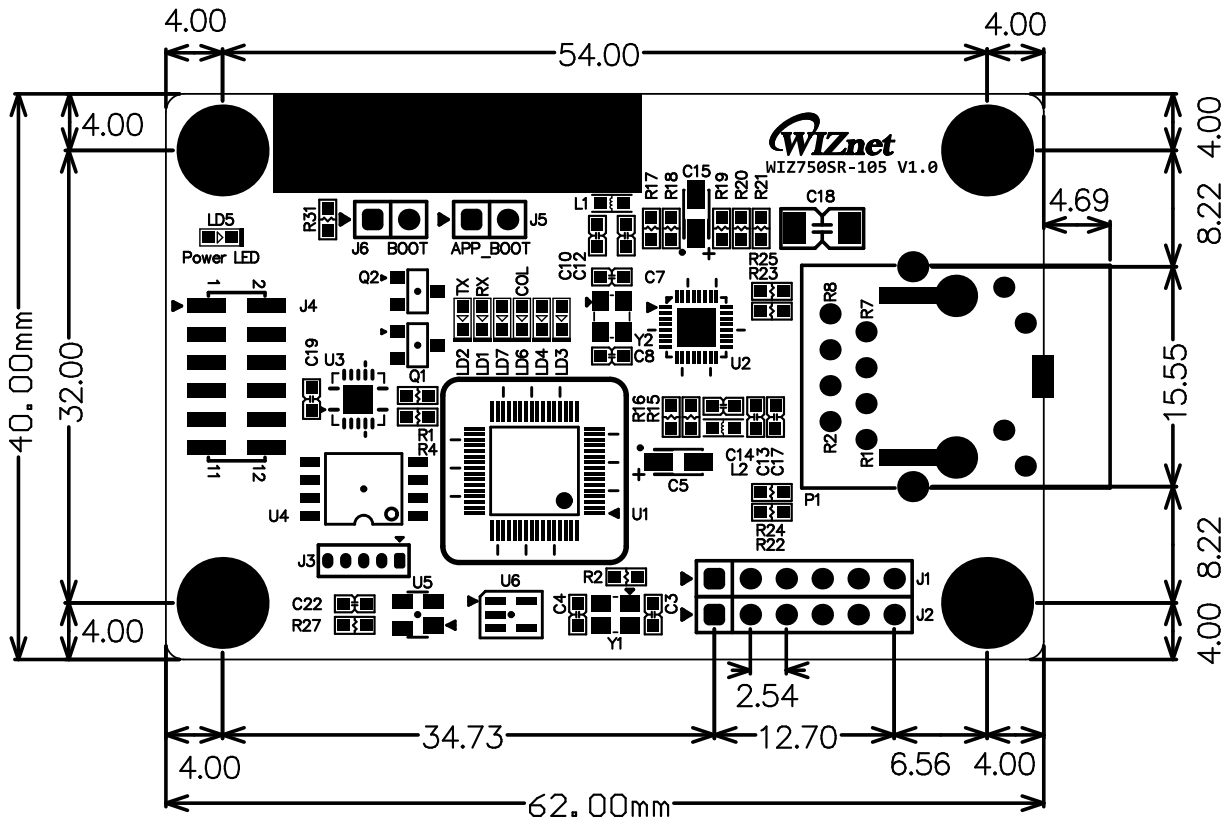
[picture p97: page 1]
