bjnhur/WIZpm/01.Serial_to_ethernet_module/06.WIZ750SR-110/05.ETC/WIZ750SR-110.pdf

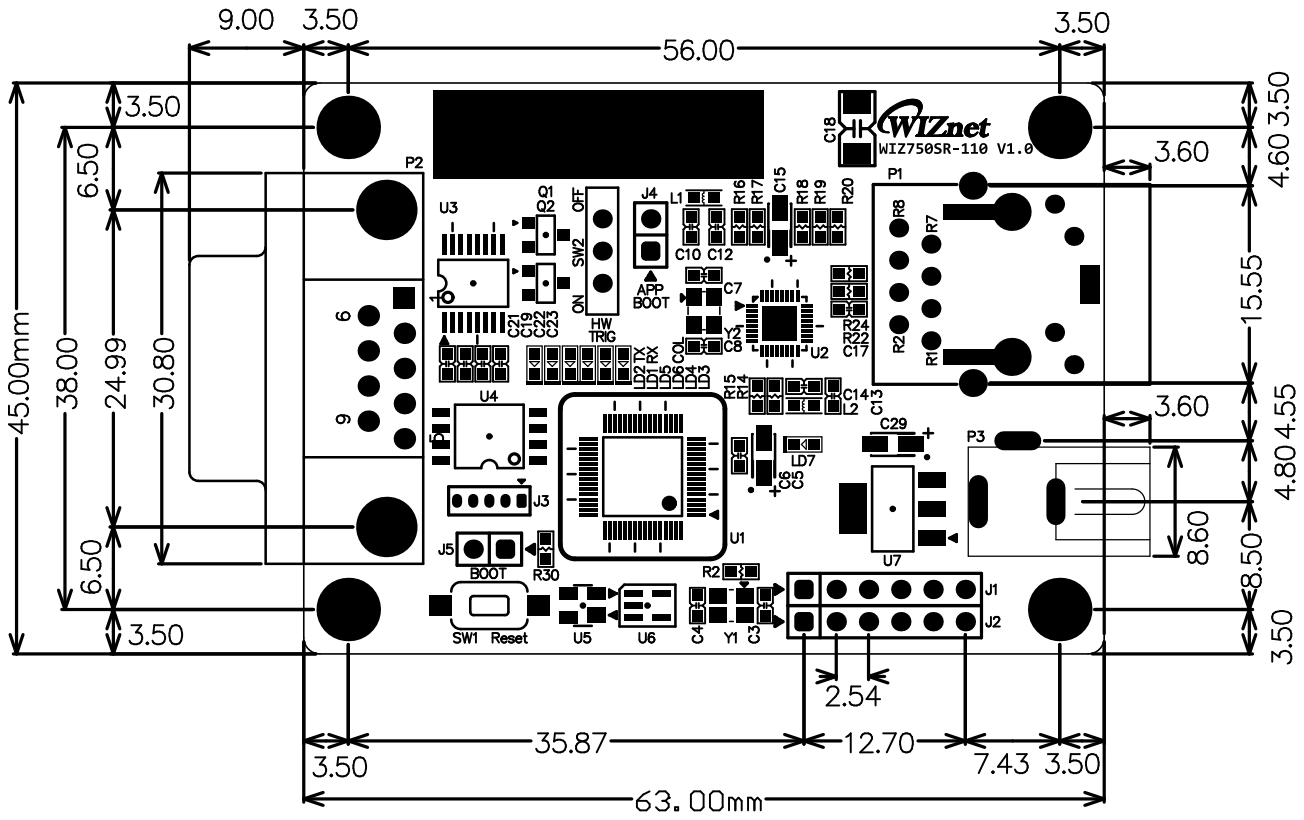
[picture p98: page 1]
