bjnhur/WIZpm/01.Serial_to_ethernet_module/01.WIZ750SR/WIZ750SR_V100/01.Hardware/01.Schematic/WIZ750SR_SCH_V100.pdf

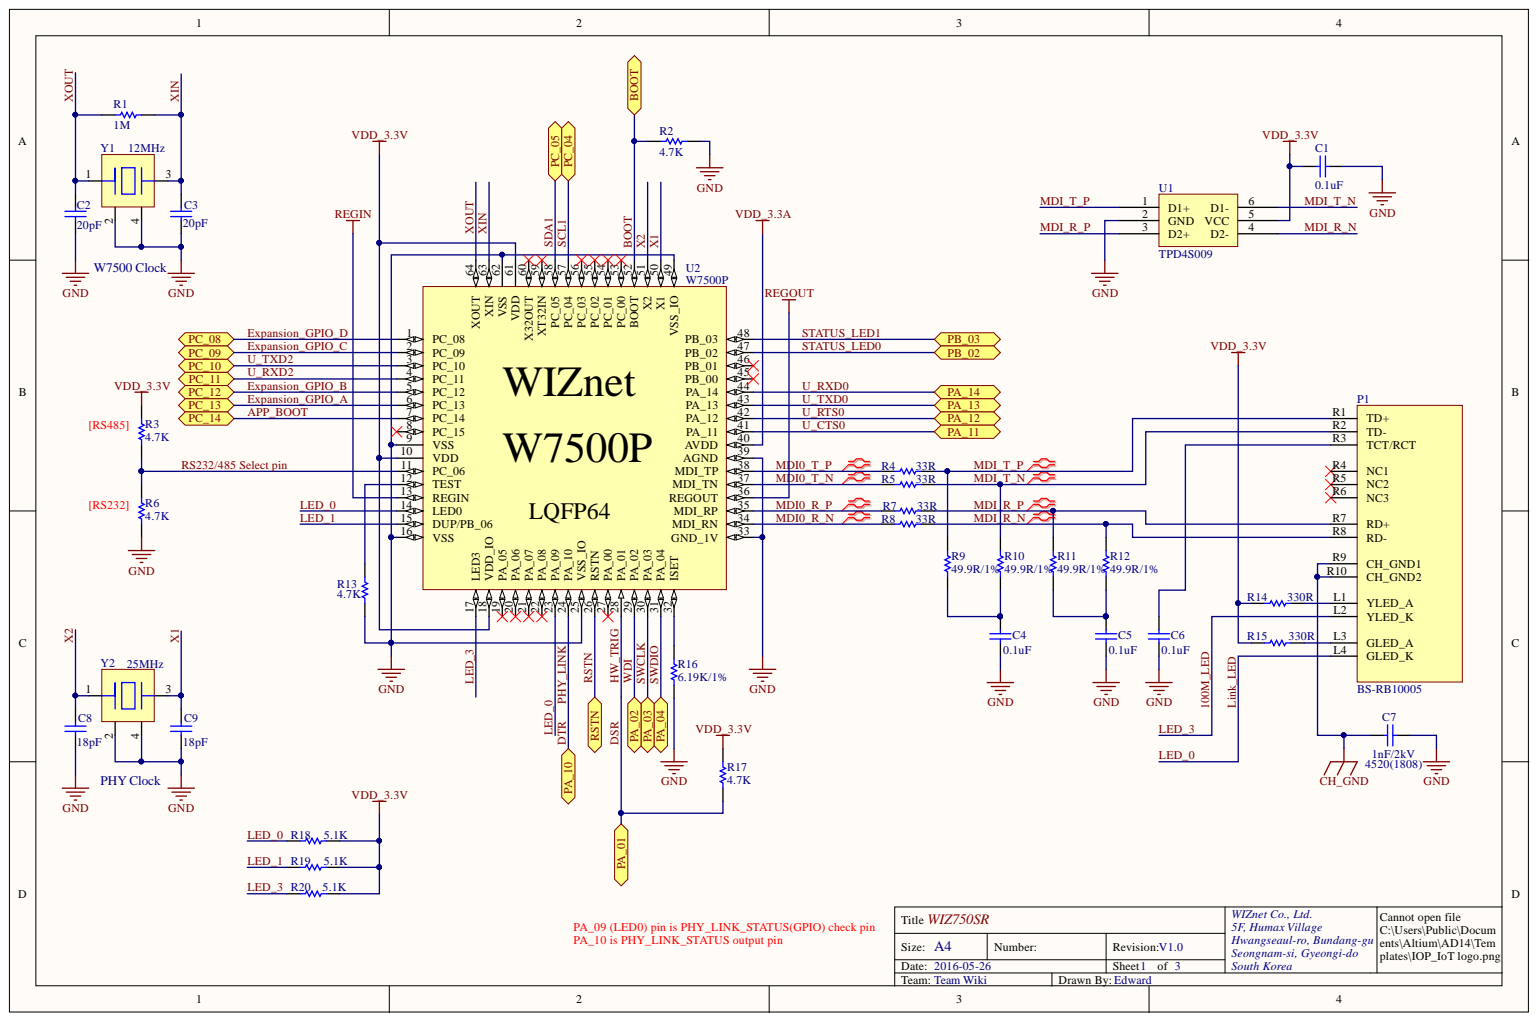
[picture p99: page 1]

48 SS_IO 49 X1 50 X2 51 BOOT 52 PC_00 53 PC_01 54 PC_02 55 PC_03 56 PC_04 57 PC_05 58 XT32IN 59 X32OUT 60 VDD 61 VSS 62 XIN 63 XOUT 64

ISET 32 GND_1V 33 MDI_RN 34 MDI_RP 35 REGOUT 36 MDI_TN 37 MDI_TP 38 AGND 39 AVDD 40 PA_11 41 PA_12 42 PA_13 43 PA_14 44 PB_00 45 PB_01 46 PB_02 47 PB_03 V

MDI0_R_N

CH_GND1 R9
CH_GND2 R10

YLED_K L2 YLED_A L1

0.1uF | | | GLED_K L4 GLED_A L3

LED_3

LED_0

WIZ750SR Title | WIZnet Co., Ltd. 5F, Humax Village Hwangseaul-ro, Bundang-gu Seongnam-si, Gyeongi-do South Korea | Cannot open file C:\Users\Public\Docum ents\Altium\AD14\Tem plates\IOP_IoT logo.png

PA_09 (LED0) pin is PHY_LINK_STATUS(GPIO) check pin
PA_10 is PHY_LINK_STATUS output pin

Size: A4 | Number: | Revision: V1.0
Date: 2016-05-26 | | Sheet of 3
Team: Team Wiki | Drawn By: Edward

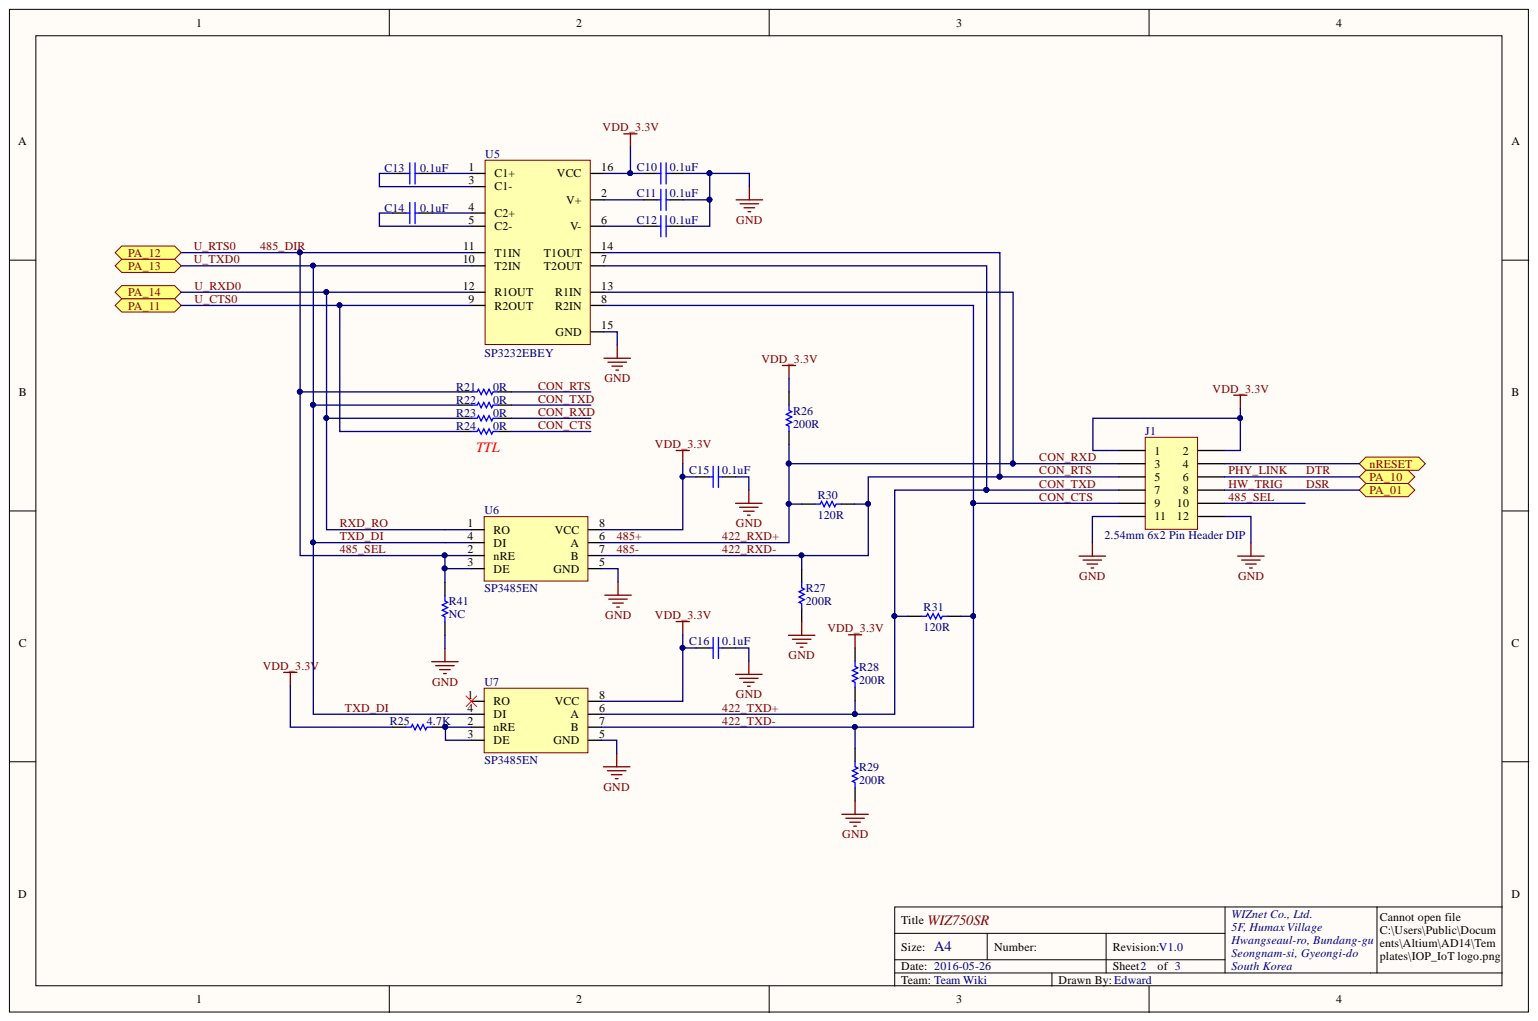
[picture p100: page 2]

R2 2
R2 3

4 8 5 _SE L | 2 | | 7 4 8 5 -4 2 2 _RX D -
V G | | 3 | | 5 | 2 0 0 R

T i t l e WIZ 75 0 SR | WIZnet Co., Lt d . 5 F, H u m ax Vi l l a g e Hwa n g sea u l-ro, B u n d a n g-g u Seo n g n a m-s i, Gyeo n g i-d o S o u t h Ko rea | Can n o t o pen fi le C: \ U sers \Pu b l ic\ D ocu m en t s \ A l t i um\ A D 1 4 \ Tem p lates \IOP_Io T l o g o.p n g

Size: A4 | N umber: | Rev i s i o n : V 1.0

6-0 5-2 | | Sheet o f
Team W i k i | Draw n By : E d ward

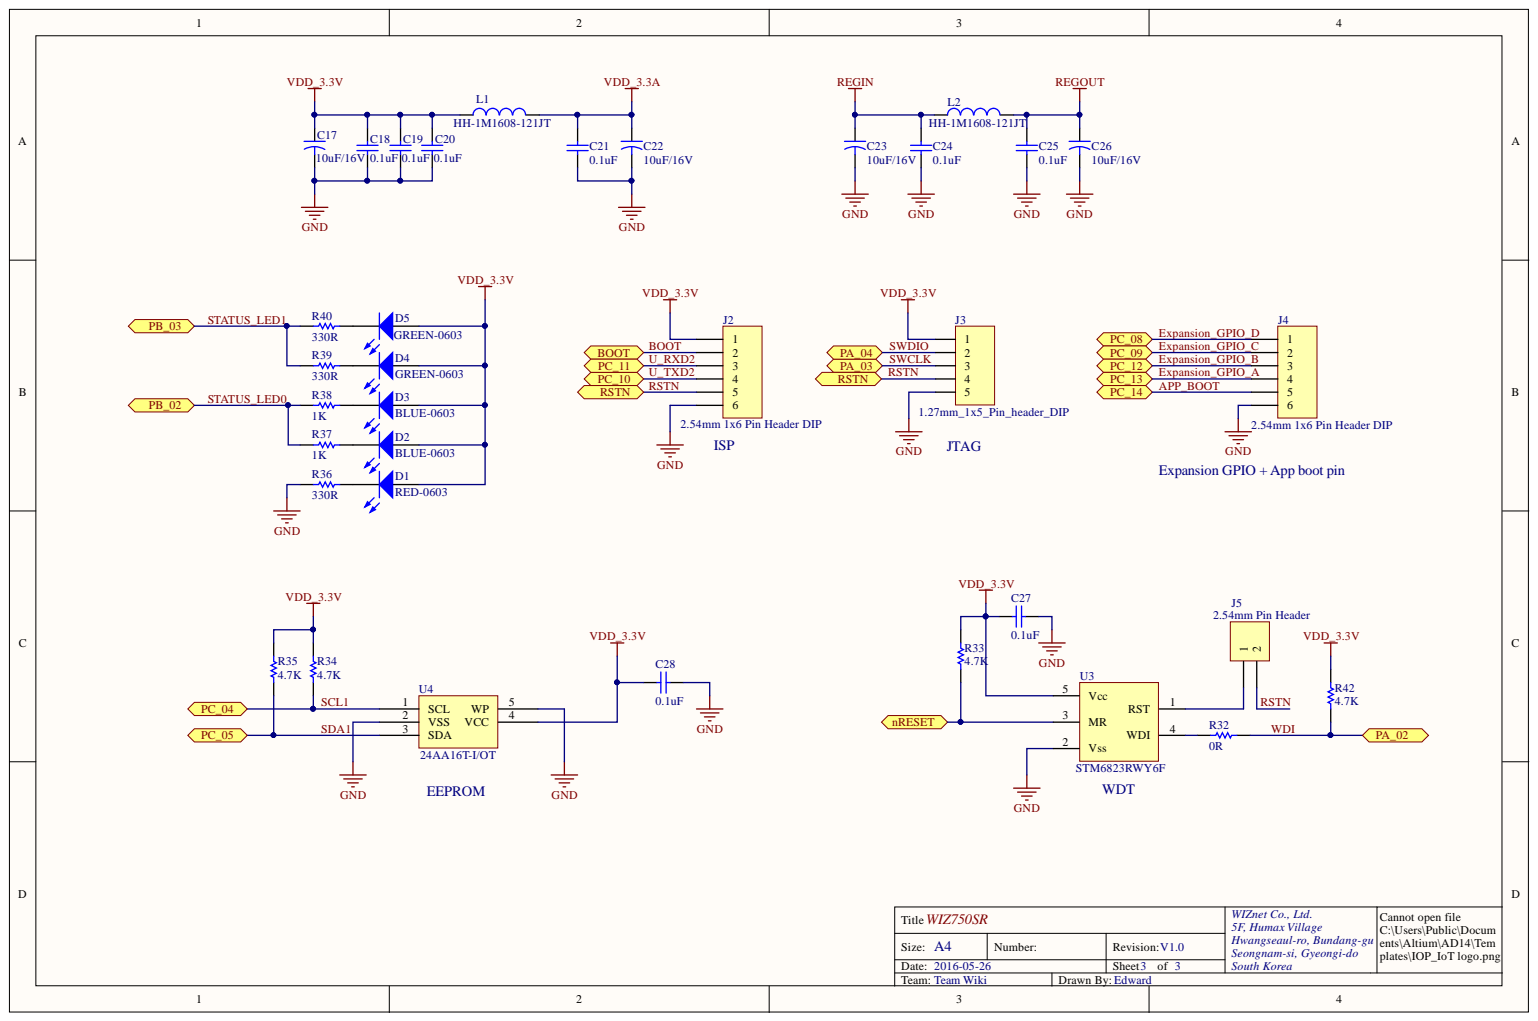
[picture p101: page 3]

Expansion GPIO + App boot pin

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
