bjnhur/WIZpm/(list of files, drawings)

Other design files:
WIZ750SR/01.Schematic/WIZ750SR_Schematic_v1.1/1.WIZ750SR_W7500P.SchDoc
WIZ750SR/01.Schematic/WIZ750SR_Schematic_v1.1/2.WIZ750SR_Transceiver.SchDoc
WIZ750SR/01.Schematic/WIZ750SR_Schematic_v1.1/3.WIZ750SR_ETC.SchDoc
WIZ750SR/01.Schematic/WIZ750SR_Schematic_v1.1/WIZ750SR.PcbDoc
WIZ750SR/01.Schematic/WIZ750SR_Schematic_v1.1/WIZ750SR.PrjPcb
