bjnhur/WIZpm/(commit log)

2018-01-22 test
    test
    [1.WIZ750SR_W7500P.SchDoc, 2.WIZ750SR_Transceiver.SchDoc, 3.WIZ750SR_ETC.SchDoc, WIZ750SR.PcbDoc, WIZ750SR.PrjPcb, wiz750sr_v1.1_pl_RS232_20171214.xls, wiz750sr_v1.1_pl_RS485_20171214.xls, wiz750sr_v1.1_pl_TTL_20171214.xls]
2018-01-22 test1
    test1
    [1.WIZ750SR_W7500P.SchDoc, 2.WIZ750SR_Transceiver.SchDoc, 3.WIZ750SR_ETC.SchDoc, WIZ750SR.PcbDoc, WIZ750SR.PrjPcb, wiz750sr_v1.1_pl_RS232_20171214.xls, wiz750sr_v1.1_pl_RS485_20171214.xls, wiz750sr_v1.1_pl_TTL_20171214.xls]
2018-01-22 First Release
    WIZ750SR Series
    [WIZ750SR-100-EVB_PL_V100.xls, WIZ750SR-100-EVB_PL_V110.xls, WIZ750SR-100_PL_V100.xls, WIZ750SR-100_PL_V110.xls, WIZ750SR-105_PL_V100.xls, WIZ750SR-110_PL_V100.xls, WIZ750SR-EVB_RS232_PL_V100.xls, WIZ750SR-EVB_RS485_PL_V100.xls]
